MohamedMehery/Cosmalla_controller/HW/usb_relay_control/SRD-05VDC-SL-C/AR0458-Relevador-5V-DC-SRD-5VDC-SL-C-Pinout.jpg

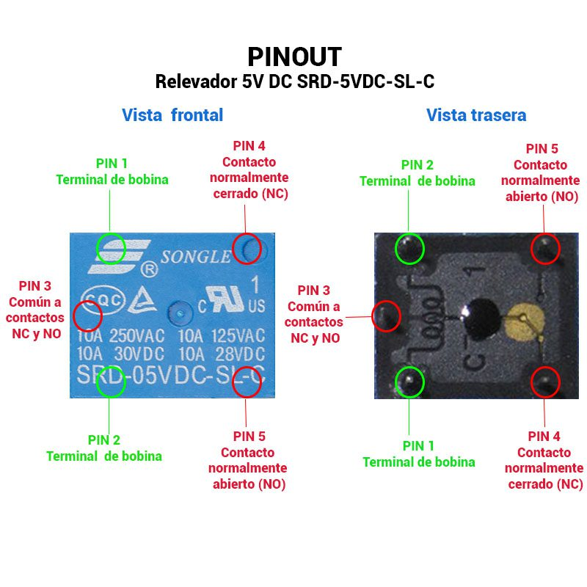
HW/usb_relay_control/SRD-05VDC-SL-C/AR0458-Relevador-5V-DC-SRD-5VDC-SL-C-Pinout.jpg
