MohamedMehery/Cosmalla_controller/HW/usb_relay_control/3D view/back view.PNG

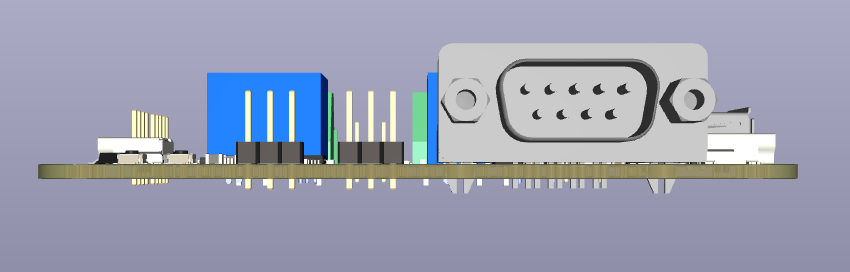
HW/usb_relay_control/3D view/back view.PNG
