MohamedMehery/Cosmalla_controller/HW/usb_relay_control/3D view/diag view.PNG

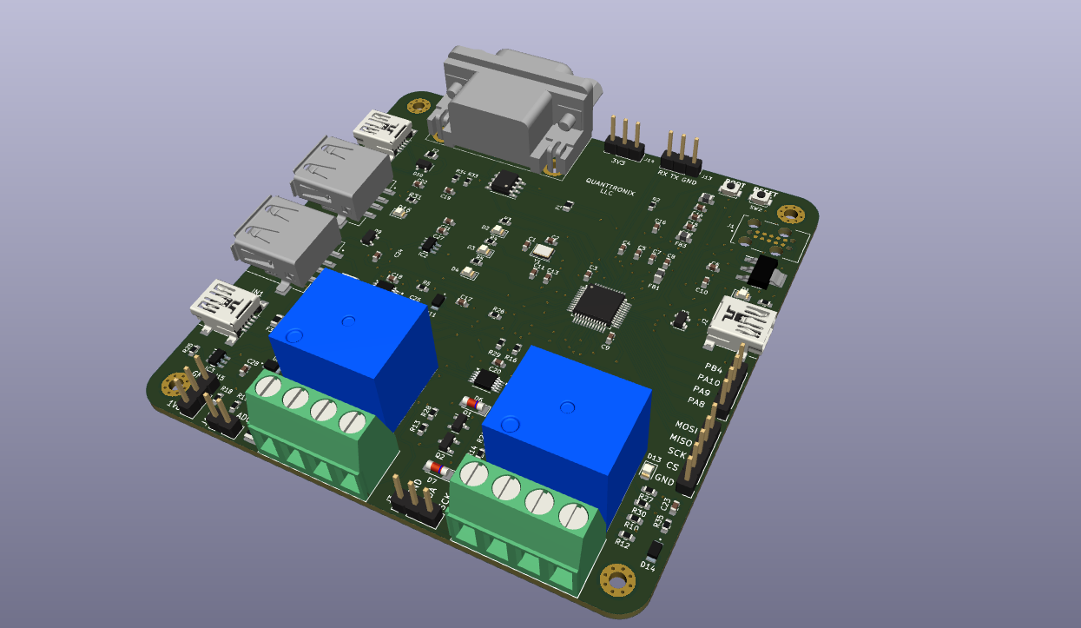
HW/usb_relay_control/3D view/diag view.PNG
