MohamedMehery/Cosmalla_controller/HW/usb_relay_control/3D view/top view.PNG

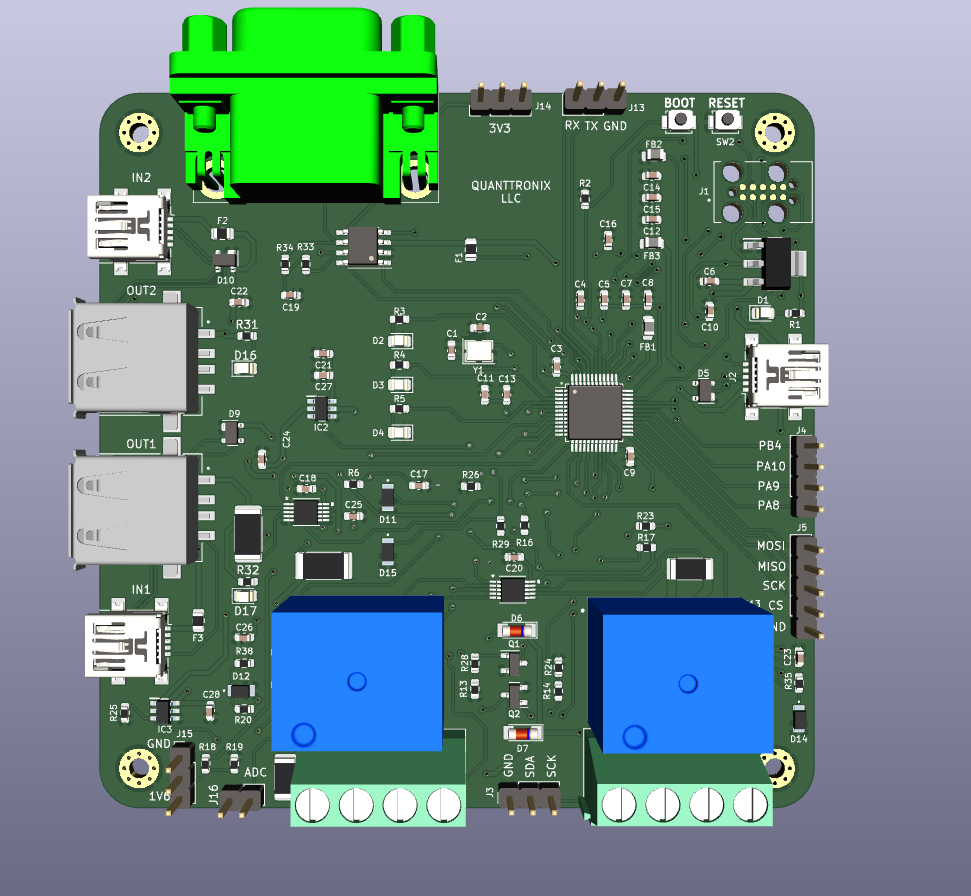
HW/usb_relay_control/3D view/top view.PNG
