MohamedMehery/Cosmalla_controller/HW/usb_relay_control/8.06.04_J-LINK_NEEDLE_ADAPTER/000000000022_IQVURnG.jpg

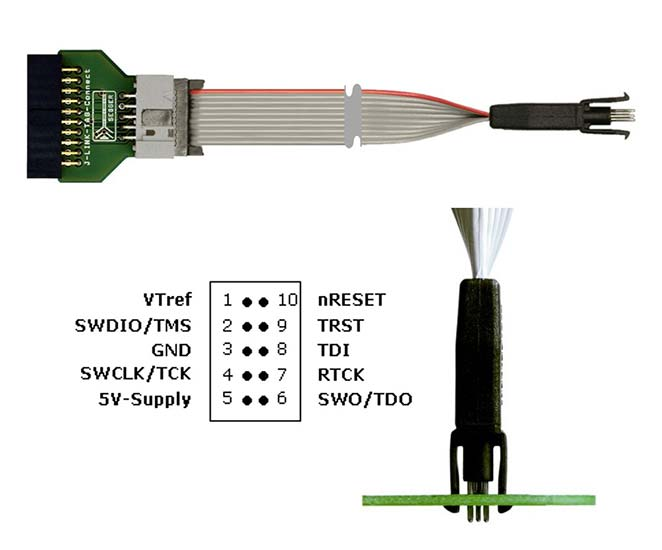
HW/usb_relay_control/8.06.04_J-LINK_NEEDLE_ADAPTER/000000000022_IQVURnG.jpg
