MohamedMehery/Cosmalla_controller/HW/usb_relay_control/relay circuit.PNG

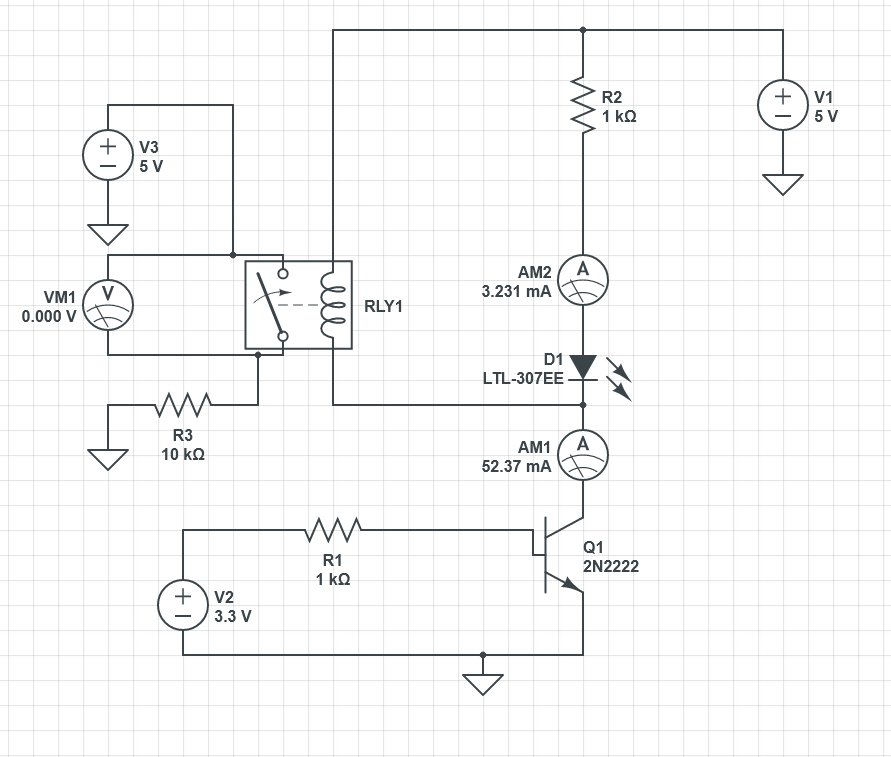
HW/usb_relay_control/relay circuit.PNG
