MohamedMehery/Cosmalla_controller/HW/usb_relay_control/BOM/Sample_BOM_PCB_DIGIKey.xlsx

PCB ASSEMBLY |  |  | xxxx xxxx xxxxx xxPCS BOM (Sample Bill of Materials)
Item # | *Designator | *Qty | Manufacturer | *Mfg Part # | Description / Value | *Package/Footprint | Type | Digikey Part # | Your Instructions / Notes
2 | J3J13J14J15J17J18J4J16J20J21J5J19 | 1 |  | 5-826629-0 | CONN HEADER VERT 50POS 2.54MM | CONN HEADER VERT 50POS 2.54MM | Through Hole | A121487-ND
6 | J6J7 | 2 | Phoenix Contact | 1729034 | 4 Position Wire to Board Terminal Block Horizontal with Board 0.197" (5.00mm) Through Hole | Horizontal with Board 0.197" (5.00mm) Through Hole | Through Hole | 277-1238-ND
7 | J11J12 | 2 | Amphenol ICC (FCI) | 87583-3010RPALF | USB-A (USB TYPE-A) USB 2.0 Receptacle Connector 4 Position Surface Mount, Right Angle | USB-A (USB TYPE-A) | SMD | 609-4946-1-ND
8 | R5 | 1 | KOA Speer Electronics, Inc. | RN73R2ATTD1670B25 | RES 167 OHM 0.1% 1/8W 0805 | 0805 | smd | 2019-RN73R2ATTD1670B25CT-ND
9 | R21R22 | 2 | Vishay Dale | WSL2512R0320FEA18 | RES 0.032 OHM 1% 2W 2512 | 2512 | smd | WSLH-.032CT-ND
10 | U4 | 1 | Texas Instruments | INA2181A1IDGSR | IC CURR SENSE 2 CIRCUIT 10VSSOP | 10-VSSOP | smd | 296-INA2181A1IDGSRCT-ND
11 | Y1 | 1 | ECS Inc. | ECS-160-9-33B-CTP-TR | CRYSTAL 16MHZ 9PF SMD |  | smd | 50-ECS-160-9-33B-CTP-CT-ND
12 | J22J23 | 2 | On Shore Technology Inc. | OSTVN02A150 | 2 Position Wire to Board Terminal Block Horizontal with Board 0.100" (2.54mm) Through Hole | 0.100" (2.54mm)Horizontal with Board | SMD | ED10561-ND
13 | IC2IC3 | 2 | Vishay Siliconix | SIP32509DT-T1-GE3 | Power Switch/Driver 1:1 N-Channel 3A TSOT-23-6 | TSOT-23-6 | SMD | SIP32509DT-T1-GE3CT-ND
14 | J10 | 1 | TE Connectivity AMP Connectors | 2311765-1 | 9 Position D-Sub Receptacle, Female Sockets Connector | Plug, FEMale Pins | SMD | 2311765-1-ND
15 | J2J8J9 | 3 | Würth Elektronik | 65100516121 | USB - mini B USB 2.0 Receptacle Connector 5 Position Surface Mount, Right Angle |  | SMD | 732-2109-1-ND
