MohamedMehery/Cosmalla_controller/HW/usb_relay_control/BOM/Sample_BOM_PCB_LCSC.xlsx

*Designator | *Qty | *Mfg Part # | *Package/Footprint | Type | LCSC Part # | Manufacturer | Description / Value | Your Instructions / Notes
C12C13C23C26C31C32C33 | 7 | VJ0805Y103KXACW1BC | 0805 (2012 Metric) | SMD | C2169545 | Vishay Intertech | 50V 10nF X7R ±10% 0805 Multilayer Ceramic Capacitors MLCC
C19 | 1 | CL21C472JBC1PNC | 0805 (2012 Metric) | SMD | C472844 | Samsung Electro-Mechanics | 50V 4.7nF C0G ±5% 0805 Multilayer Ceramic Capacitors MLCC - SMD/SMT ROHS
C1C2 | 2 | CC0805DRNPO9BN8R0 | 0805 (2012 Metric) | SMD | C519959 | YAGEO | 50V 8pF NP0 0805 Multilayer Ceramic Capacitors MLCC - SMD/SMT ROHS
C3C14C21C22C10 | 5 | GRT21BC8YA475KE13L | 0805 (2012 Metric) | SMD | C711102 | Murata Electronics | 35V 4.7uF X6S ±10% 0805 Multilayer Ceramic Capacitors MLCC - SMD/SMT ROHS
C15C16C17C18C20C24C25C27C28C29C30C35 | 12 | VJ0805Y104KXATW1BC | 0805 (2012 Metric) | SMD | C2169721 | Vishay Intertech | 50V 100nF X7R ±10% 0805 Multilayer Ceramic Capacitors MLCC - SMD/SMT ROHS
C6C11 | 2 | AC0805KKX7R6BB105 | 0805 (2012 Metric) | SMD | C726581 | YAGEO | 10V 1uF X7R ±10% 0805 Multilayer Ceramic Capacitors MLCC - SMD/SMT ROHS
C34 | 1 | GRM21BR60G476ME01L | 0805 (2012 Metric) | SMD | C5274022 | Murata Electronics | 4V 47uF ±20% 0805 Multilayer Ceramic Capacitors MLCC - SMD/SMT ROHS
C4C5C7C8C9 | 5 | GRT21BC71E106KE13L | 0805 (2012 Metric) | SMD | C882505 | Murata Electronics | 25V 10uF ±10% 0805 Multilayer Ceramic Capacitors MLCC - SMD/SMT ROHS
D1D2D16D17D8D13 | 6 | MHT170CRCT | 0805 (2012 Metric) | SMD | C389523 | MEIHUA | 617.5nm~633.5nm Red 0805 Light Emitting Diodes (LED) ROHS
D3 | 1 | LTST-C171GKT | 0805 (2012 Metric) | SMD | C913075 | LTST-C171GKT | GREENLED
D4 | 1 | NCD0805G1 | 0805 (2012 Metric) | SMD | C84260 | Lite-On Inc. | BLUELED
D5D9D10D18D19 | 5 | PRTR5V0U2X,215 | SOT-143B | SMD | C12333 | Nexperia USA Inc. | TVS DIODE 5.5VWM SOT143B
D6D7 | 2 | TZMC75-GS08 | SOD-80 | smd | C3013862 | Vishay Intertech | Diode 100 V 150mA Surface Mount Mini MELF
DNP_R39DNP_R40 | 2 | RC0805FR-0710KL | 0805 | smd | C84376 | YAGEO | 10 kOhms ±5% 0.25W, Chip Resistor 0603 (1608 Metric)
F1F2F3 | 3 | 0805L100WR | 0805 (2012 Metric), Concave | SMD | C80270 | Littelfuse Inc. | Polymeric PTC Resettable Fuse 6V 1 A Ih Surface Mount 0805 (2012 Metric), Concave
FB1FB2FB3 | 3 | MPZ2012S101ATD25 | 0805 | smd | C307776 | TDK | 20mΩ 100Ω@100MHz 0805 Ferrite Beads ROHS
IC1 | 1 | LDL1117S33R | SOT-223 | SMD | C435835 | STMicroelectronics | Linear Voltage Regulator IC Positive Fixed 1 Output 1.2A SOT-223
R11R12 | 2 | RT0805CRD0747KL | 0805 | smd | C868380 | YAGEO | 125mW Thin Film Resistor ±0.25% 47kΩ 0805 Chip Resistor - Surface Mount ROHS
R14R15R27R28RR31R32 | 6 | AR05CTC1000 | 0805 | smd | C2902822 | Viking Tech | 100mW Thin Film Resistor ±0.25% 1kΩ 0805 Chip Resistor - Surface Mount ROHS
R16R20R30 | 3 | AR05DTCW0100 | 0805 | smd | C319925 | Viking Tech (https://www.lcsc.com/brand-detail/346.html) | 125mW Thin Film Resistor ±0.5% 10Ω 0805 Chip Resistor - Surface Mount ROHS
R17R23 | 2 | RT0805BRD071K78L | 0805 | smd | C706226 | YAGEO | 125mW Thin Film Resistor ±0.1% 1.78kΩ 0805 Chip Resistor - Surface Mount ROHS
R1R3 | 2 | PTFR0805B332RP9 | 0805 | smd | C2849181 | Resistor.Today | 0.13W Thin Film Resistor ±0.1% 332Ω 0805 Chip Resistor - Surface Mount ROHS
R29R35R36R37R38 | 5 | AR05BTCW1500 | 0805 | smd | C319863 | Viking Tech | 125mW Thin Film Resistor ±0.1% 150Ω 0805 Chip Resistor
R2R6R13R18R19R24R25R26 | 8 | RC0805FR-0710KL | 0805 | smd | C84376 | YAGEO | 200mW Thin Film Resistor ±0.1% 10kΩ 0805 Chip Resistor
R33R34 | 2 | CRCW080560R4FKEAHP | 0805 | smd | C1880864 | Vishay Intertech | 500mW Thick Film Resistors ±1% 60.4Ω 0805 Chip Resistor
R4 | 1 | HPCR0805F300RK9 | 0805 | smd | C365284 | Resistor.Today | 250mW Thick Film Resistors ±1% 300Ω 0805 Chip Resistor
R41R42 R43 | 3 | PA0805-R-470RL | 0805 | SMD | C858567 | YAGEO | 1/5W 0Ω 0805 Chip Resistor - Surface Mount ROHS
R7R9 | 2 | RLM20FECR020 | 2010 | smd | C912937 | TA-I Tech | RES 0.02 OHM 1% 2010
R8R10 | 2 | RT0805BRD07124KL | 0805 | smd | C865165 | YAGEO | 125mW Thin Film Resistor ±0.1% 124kΩ 0805 Chip Resistor
R44R45 | 2 | PTFR0805B100KP9 | 0806 | smd | C478884 | Resistor.Today | 100K
R46 | 1 | PTFR0805B1K50N9 | 0805 | SMD | C351598 | Resistor.Today | 1.5K
SW1SW2 | 2 | B3U-1000P | 0805 | smd | C231329 | Omron Electronics Inc-EMC Div | SWITCH TACTILE SPST-NO 0.05A 12V
U1 | 1 | STM32F103CBT6 | 48-LQFP | smd | C8304 | STMicroelectronics | ARM® Cortex®-M3 STM32F1 Microcontroller IC 32-Bit Single-Core 72MHz 128KB (128K x 8) FLASH
U3 | 1 | TJA1051T/3,118 | SOIC-8 | SMD | C58988 | NXP Semiconductors (https://www.mouser.com/manufacturer/nxp-semiconductors/) | CAN Interface IC Hi Spd CAN Transcvr 4.5V-5.5V 250ns
