MohamedMehery/Cosmalla_controller/HW/usb_relay_control/BOM/Sample_BOM_PCB_Mouser.xlsx

Sheet: Sheet1
Item # | *Designator | *Qty | Manufacturer | *Mfg Part # | Description / Value | *Package/Footprint | Type | Mouser Part # | Your Instructions / Notes
1 | U2 | 1 | Texas Instruments (https://www.mouser.com/manufacturer/texas-instruments/) | INA2181A3QDGSRQ1 | Current Sense Amplifiers AEC-Q100, 26V, dual channel, bi-directional, 350kHz current sense amplifier 10-VSSOP -40 to 125 | MSOP-10 | SMD | 595-INA2181A3QDGSRQ1
2 | U3 | 1 | NXP Semiconductors (https://www.mouser.com/manufacturer/nxp-semiconductors/) | TJA1051T/3,118 | CAN Interface IC Hi Spd CAN Transcvr 4.5V-5.5V 250ns | SOIC-8 | SMD | 771-TJA1051T3118 |  | On LCSC
2 | D11D12D14 | 3 | Taiwan Semiconductor (https://www.mouser.com/manufacturer/taiwan-semiconductor/) | BZY55C3V3 RYG | Zener Diodes 500mW, 2%, Small Signal Zener Diode | 0805 | SMD | 821-BZY55C3V3RYG
3 | Q1Q2 | 2 | Diotec Semiconductor (https://www.mouser.com/manufacturer/diotec-semiconductor/) | MMBT3904 | Bipolar Transistors - BJT BJT, SOT-23, 40V, 200mA, NPN | SOT-23 | SMD | 637-MMBT3904
4 | F6 | 1 | Bourns (https://www.mouser.com/manufacturer/bourns/) | SF-0603S070-2 | Surface Mount Fuses 0.7A Slow Blow 0603 Singlfuse | 0603 | SMD | 652-SF-0603S070-2
5 | F4F5 | 2 | KYOCERA AVX (https://www.mouser.com/manufacturer/kyocera-avx/) | F0603G0R02FNTR | Surface Mount Fuses 0603 28mA 63V 0603 | 0603 | SMD | 581-F0603G0R02FNTR

Sheet: Sheet2
Item # | *Designator | *Qty | Manufacturer | *Mfg Part # | Description / Value | *Package/Footprint | Type | Mouser Part # | Your Instructions / Notes
1 | U2 | 1 | Texas Instruments (https://www.mouser.com/manufacturer/texas-instruments/) | INA2181A3QDGSRQ1 | Current Sense Amplifiers AEC-Q100, 26V, dual channel, bi-directional, 350kHz current sense amplifier 10-VSSOP -40 to 125 | MSOP-10 | SMD | 595-INA2181A3QDGSRQ1
2 | U3 | 1 | NXP Semiconductors (https://www.mouser.com/manufacturer/nxp-semiconductors/) | TJA1051T/3,118 | CAN Interface IC Hi Spd CAN Transcvr 4.5V-5.5V 250ns | SOIC-8 | SMD | 771-TJA1051T3118 |  | On LCSC
3 | D11D12D14D15 | 4 | Taiwan Semiconductor (https://www.mouser.com/manufacturer/taiwan-semiconductor/) | BZY55B3V3 RBG | Zener Diodes 500mW, 2%, Small Signal Zener Diode | 0805 | SMD | 821-BZY55B3V3RBG
4 | Q1Q2 | 2 | Diotec Semiconductor (https://www.mouser.com/manufacturer/diotec-semiconductor/) | MMBT3904 | Bipolar Transistors - BJT BJT, SOT-23, 40V, 200mA, NPN | SOT-23 | SMD | 637-MMBT3904
