MohamedMehery/Cosmalla_controller/HW/usb_relay_control/8.06.04_J-LINK_NEEDLE_ADAPTER/8.06.04_J-LINK_NEEDLE_ADAPTER.step

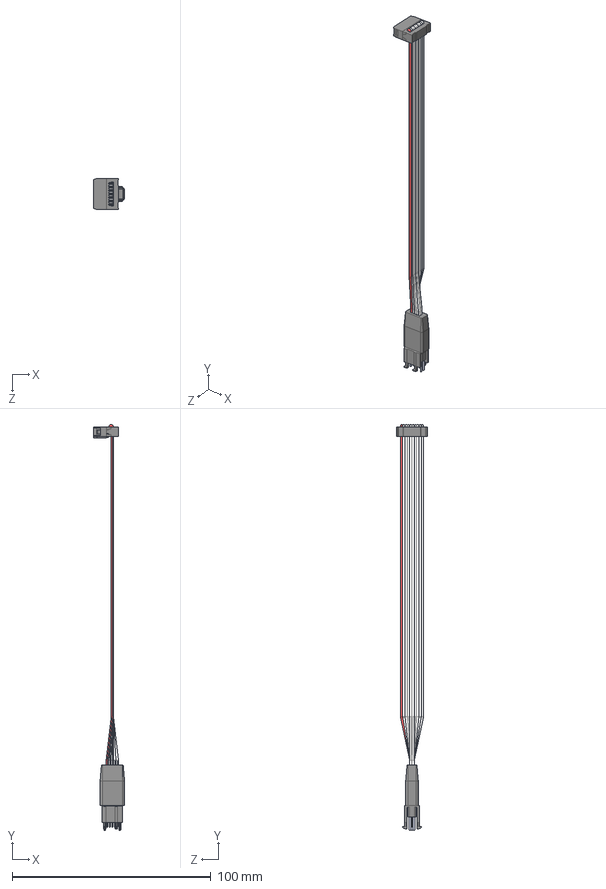
[picture p11: CAD file, 2026-05-07]
HW/usb_relay_control/8.06.04_J-LINK_NEEDLE_ADAPTER/8.06.04_J-LINK_NEEDLE_ADAPTER.step
15.7 x 204.4 x 15.7 mm
8.06.04 J-LINK NEEDLE ADAPTER
cable and adapter
