MohamedMehery/Cosmalla_controller/HW/usb_relay_control/INA4181A1IPWR/INA4181A1IPWR.step

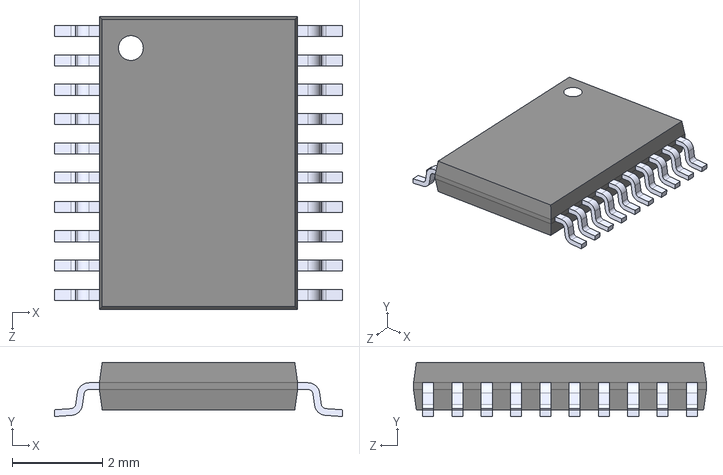
[picture p12: CAD file, 2026-05-07]
HW/usb_relay_control/INA4181A1IPWR/INA4181A1IPWR.step
6.40 x 1.20 x 6.50 mm
