MohamedMehery/Cosmalla_controller/HW/usb_relay_control/LDL1117S33R/LDL1117S33R.step

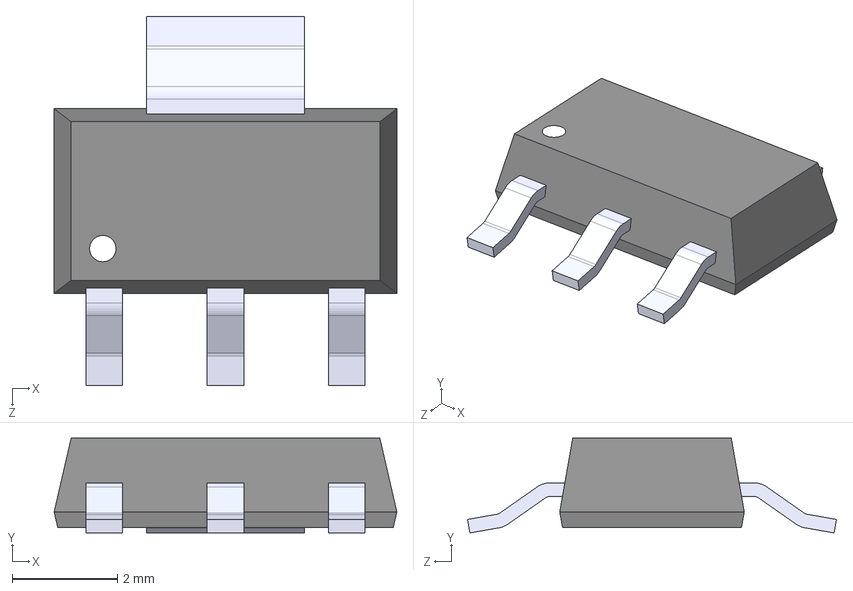
[picture p13: CAD file, 2026-05-08]
HW/usb_relay_control/LDL1117S33R/LDL1117S33R.step
6.50 x 1.80 x 7.00 mm
