MohamedMehery/Cosmalla_controller/HW/usb_relay_control/LIB_BZY55B3V3_RBG/BZY55B3V3_RBG/3D/BZY55B3V3_RBG.stp

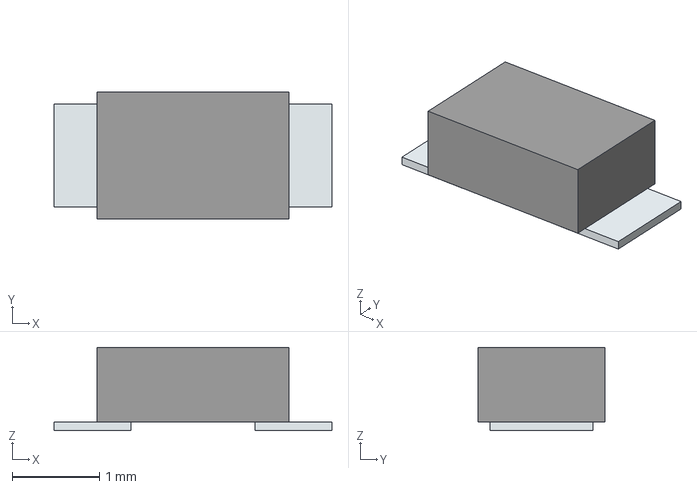
[picture p14: CAD file, 2026-05-08]
HW/usb_relay_control/LIB_BZY55B3V3_RBG/BZY55B3V3_RBG/3D/BZY55B3V3_RBG.stp
3.18 x 1.45 x 0.95 mm
Pins
