MohamedMehery/Cosmalla_controller/HW/usb_relay_control/LIB_IRF7470TRPBF/IRF7470TRPBF/3D/IRF7470TRPBF.stp

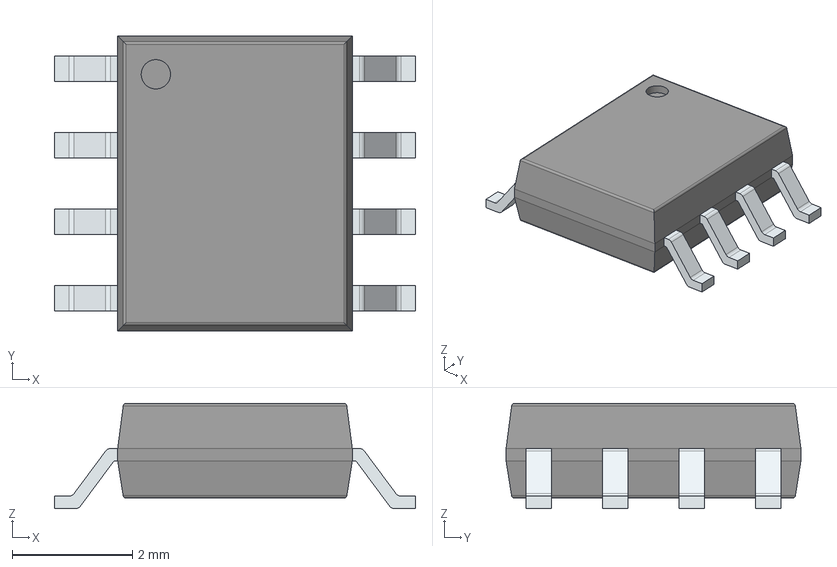
[picture p15: CAD file, 2026-05-08]
HW/usb_relay_control/LIB_IRF7470TRPBF/IRF7470TRPBF/3D/IRF7470TRPBF.stp
6.00 x 4.90 x 1.75 mm
PinsArrayLR
