MohamedMehery/Cosmalla_controller/HW/usb_relay_control/LIB_LDL1117S50R/LDL1117S50R/3D/LDL1117S50R.stp

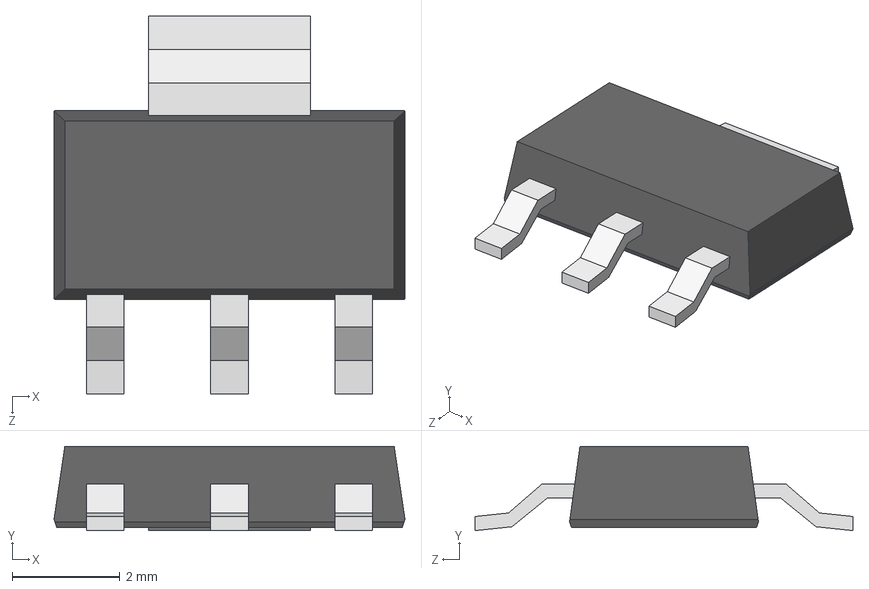
[picture p16: CAD file, 2026-05-07]
HW/usb_relay_control/LIB_LDL1117S50R/LDL1117S50R/3D/LDL1117S50R.stp
6.50 x 1.56 x 7.00 mm
