MohamedMehery/Cosmalla_controller/HW/usb_relay_control/LIB_LMR1802G-LBTR/LMR1802G-LBTR/3D/LMR1802G-LBTR.stp

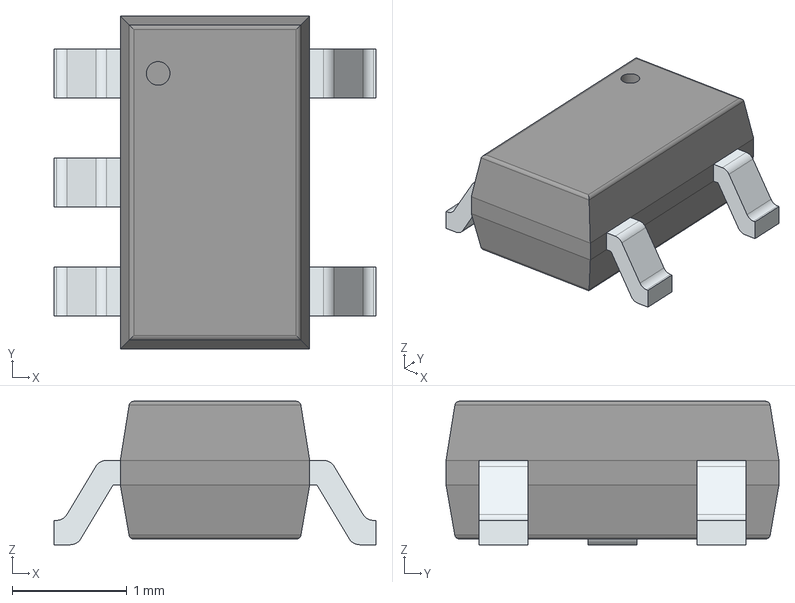
[picture p17: CAD file, 2026-05-07]
HW/usb_relay_control/LIB_LMR1802G-LBTR/LMR1802G-LBTR/3D/LMR1802G-LBTR.stp
2.80 x 2.90 x 1.25 mm
PinsArrayL
PinsArrayR
