MohamedMehery/Cosmalla_controller/HW/usb_relay_control/LIB_MAX7301AAX/MAX7301AAX+/3D/MAX7301AAX+.stp

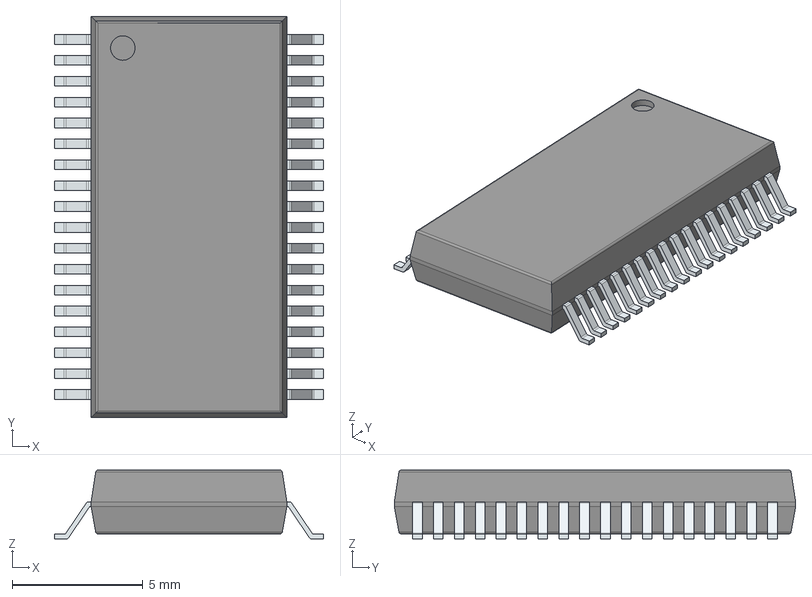
[picture p18: CAD file, 2026-05-07]
HW/usb_relay_control/LIB_MAX7301AAX/MAX7301AAX+/3D/MAX7301AAX+.stp
10.3 x 15.4 x 2.64 mm
PinsArrayLR
