MohamedMehery/Cosmalla_controller/HW/usb_relay_control/LIB_MMBT2222LT1G/MMBT2222LT1G/MMBT2222LT1G.stp

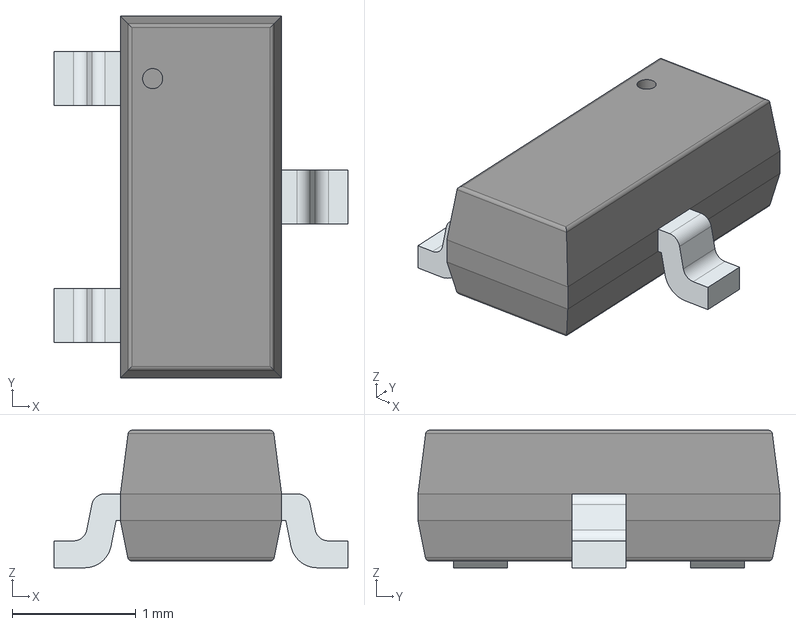
[picture p19: CAD file, 2026-05-08]
HW/usb_relay_control/LIB_MMBT2222LT1G/MMBT2222LT1G/MMBT2222LT1G.stp
2.37 x 2.92 x 1.11 mm
PinsArrayL
FilletPinR
