MohamedMehery/Cosmalla_controller/HW/usb_relay_control/LIB_TCAN1042HDRQ1/TCAN1042HDRQ1/3D/TCAN1042HDRQ1.stp

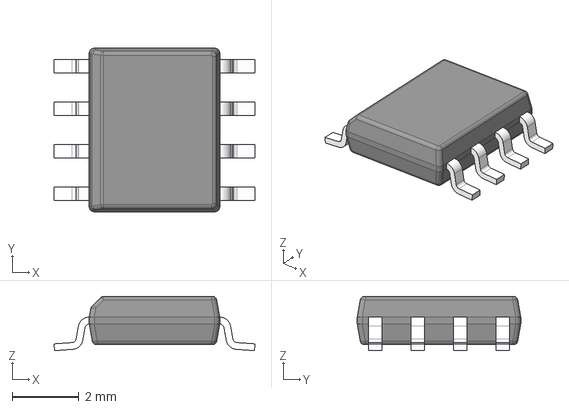
[picture p20: CAD file, 2026-05-07]
HW/usb_relay_control/LIB_TCAN1042HDRQ1/TCAN1042HDRQ1/3D/TCAN1042HDRQ1.stp
6.02 x 4.90 x 1.63 mm
BODY-SO
LEAD-D0008A x 8
