MohamedMehery/Cosmalla_controller/HW/usb_relay_control/SRD-05VDC-SL-C/SRD-05VDC-SL-C.step

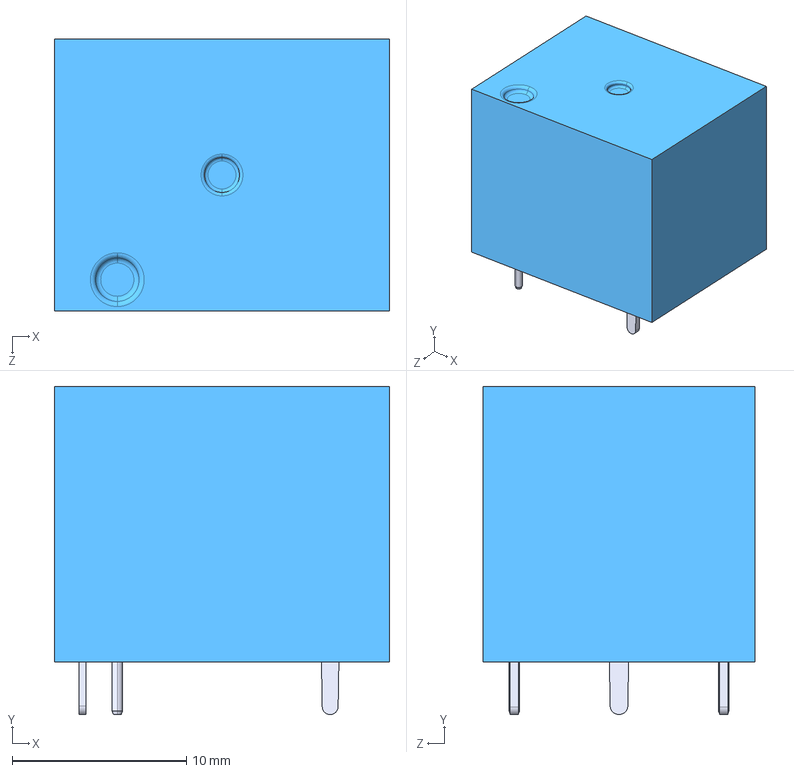
[picture p21: CAD file, 2026-05-07]
HW/usb_relay_control/SRD-05VDC-SL-C/SRD-05VDC-SL-C.step
19.2 x 18.8 x 15.6 mm
