MohamedMehery/Cosmalla_controller/HW/usb_relay_control/ul_INA2181A1IDGSR/ul_INA2181A1IDGSR/2023-02-03_08-18-01/DGS0010A.stp

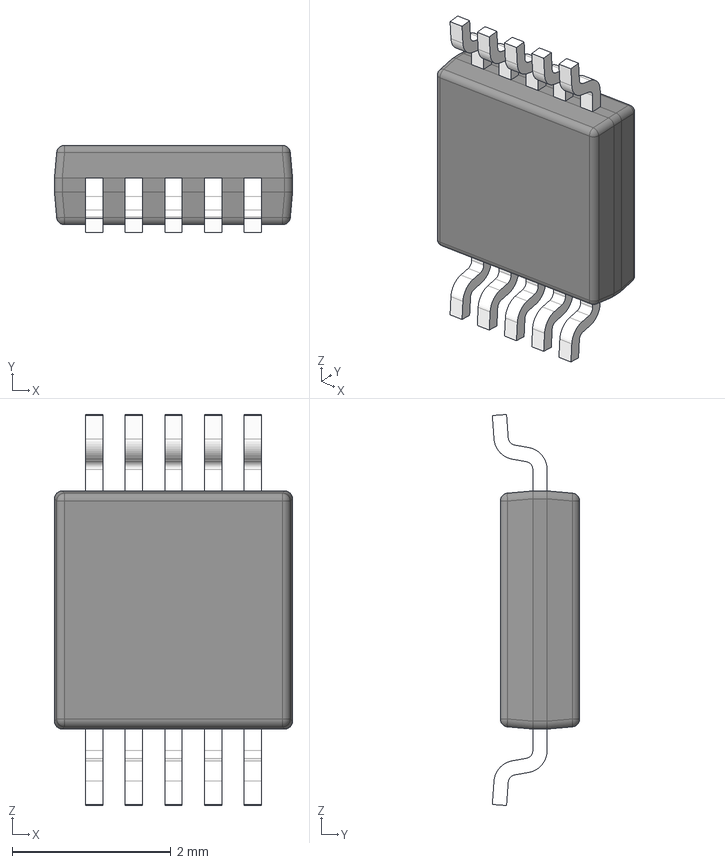
[picture p22: CAD file, 2026-05-08]
HW/usb_relay_control/ul_INA2181A1IDGSR/ul_INA2181A1IDGSR/2023-02-03_08-18-01/DGS0010A.stp
3.00 x 1.10 x 4.93 mm
BODY-SO
LEAD-SO x 10
PIN1-ID
