MohamedMehery/Cosmalla_controller/HW/usb_relay_control/136415089-659-2301843-1/2301843-1.stp

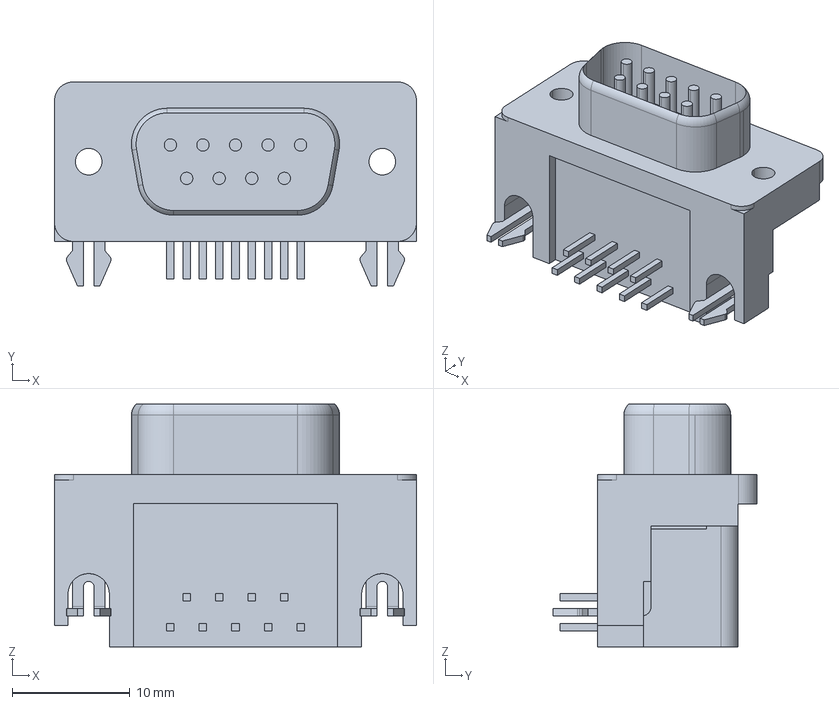
[picture p23: CAD file, 2026-05-08]
HW/usb_relay_control/136415089-659-2301843-1/2301843-1.stp
30.8 x 17.4 x 20.6 mm
