MohamedMehery/Cosmalla_controller/HW/usb_relay_control/LIB_2301843-2/2301843-2/3D/2301843-2.stp

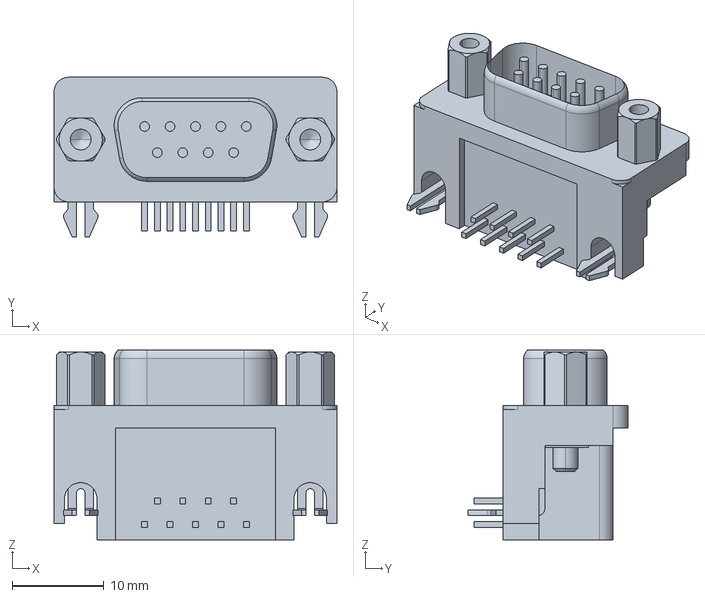
[picture p24: CAD file, 2026-05-07]
HW/usb_relay_control/LIB_2301843-2/2301843-2/3D/2301843-2.stp
30.8 x 17.4 x 20.6 mm
