MohamedMehery/Cosmalla_controller/HW/usb_relay_control/LIB_292303-9/292303-9/292303-9/292303-9.step

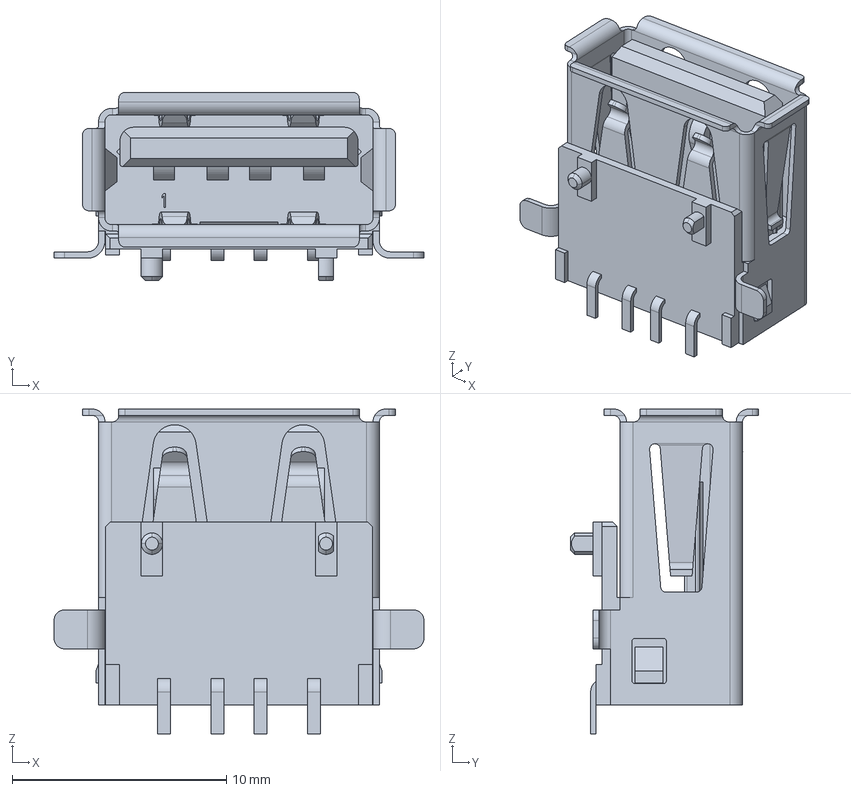
[picture p25: CAD file, 2026-05-08]
HW/usb_relay_control/LIB_292303-9/292303-9/292303-9/292303-9.step
17.3 x 8.79 x 15.2 mm
