MohamedMehery/Cosmalla_controller/HW/usb_relay_control/LIB_87583-3010RPALF/87583-3010RPALF--3DModel-STEP-269445.STEP

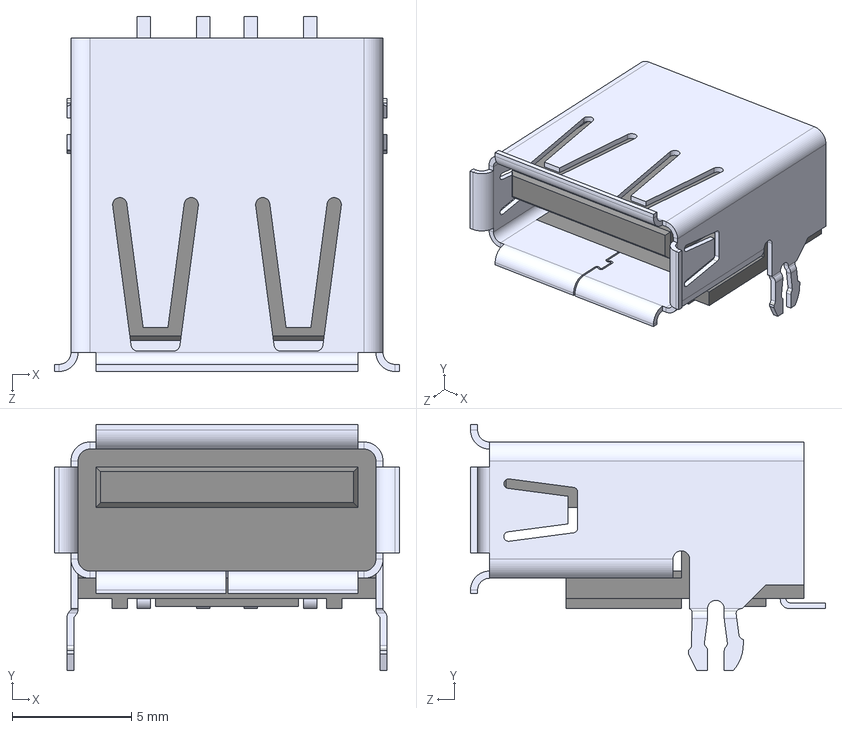
[picture p26: CAD file, 2026-05-08]
HW/usb_relay_control/LIB_87583-3010RPALF/87583-3010RPALF--3DModel-STEP-269445.STEP
14.5 x 10.3 x 14.9 mm
