MohamedMehery/Cosmalla_controller/(list of files, cad)

Other CAD files:
HW/usb_relay_control/LIB_292303-9/292303-9/3D/292303-9.stp
HW/usb_relay_control/LIB_87583-3010RPALF/87583-3010RPALF/3D/87583-3010RPALF.stp
HW/usb_relay_control/LIB_LDL1117S50R/LDL1117S50R/Allegro/sot230p700x180-4n.psm
HW/usb_relay_control/LIB_LDL1117S50R/LDL1117S50R/DEHDL/ldl1117s50r/chips/chips.prt
HW/usb_relay_control/LIB_LMR1802G-LBTR/LMR1802G-LBTR/Allegro/sot95p280x125-5n.psm
HW/usb_relay_control/LIB_LMR1802G-LBTR/LMR1802G-LBTR/DEHDL/lmr1802g_lbtr/chips/chips.prt
HW/usb_relay_control/LIB_SIP32509DT-T1-GE3/SIP32509DT-T1-GE3/3D/SIP32509DT-T1-GE3.stp
