MohamedMehery/Cosmalla_controller/HW/usb_relay_control/usb_relay_control.pdf

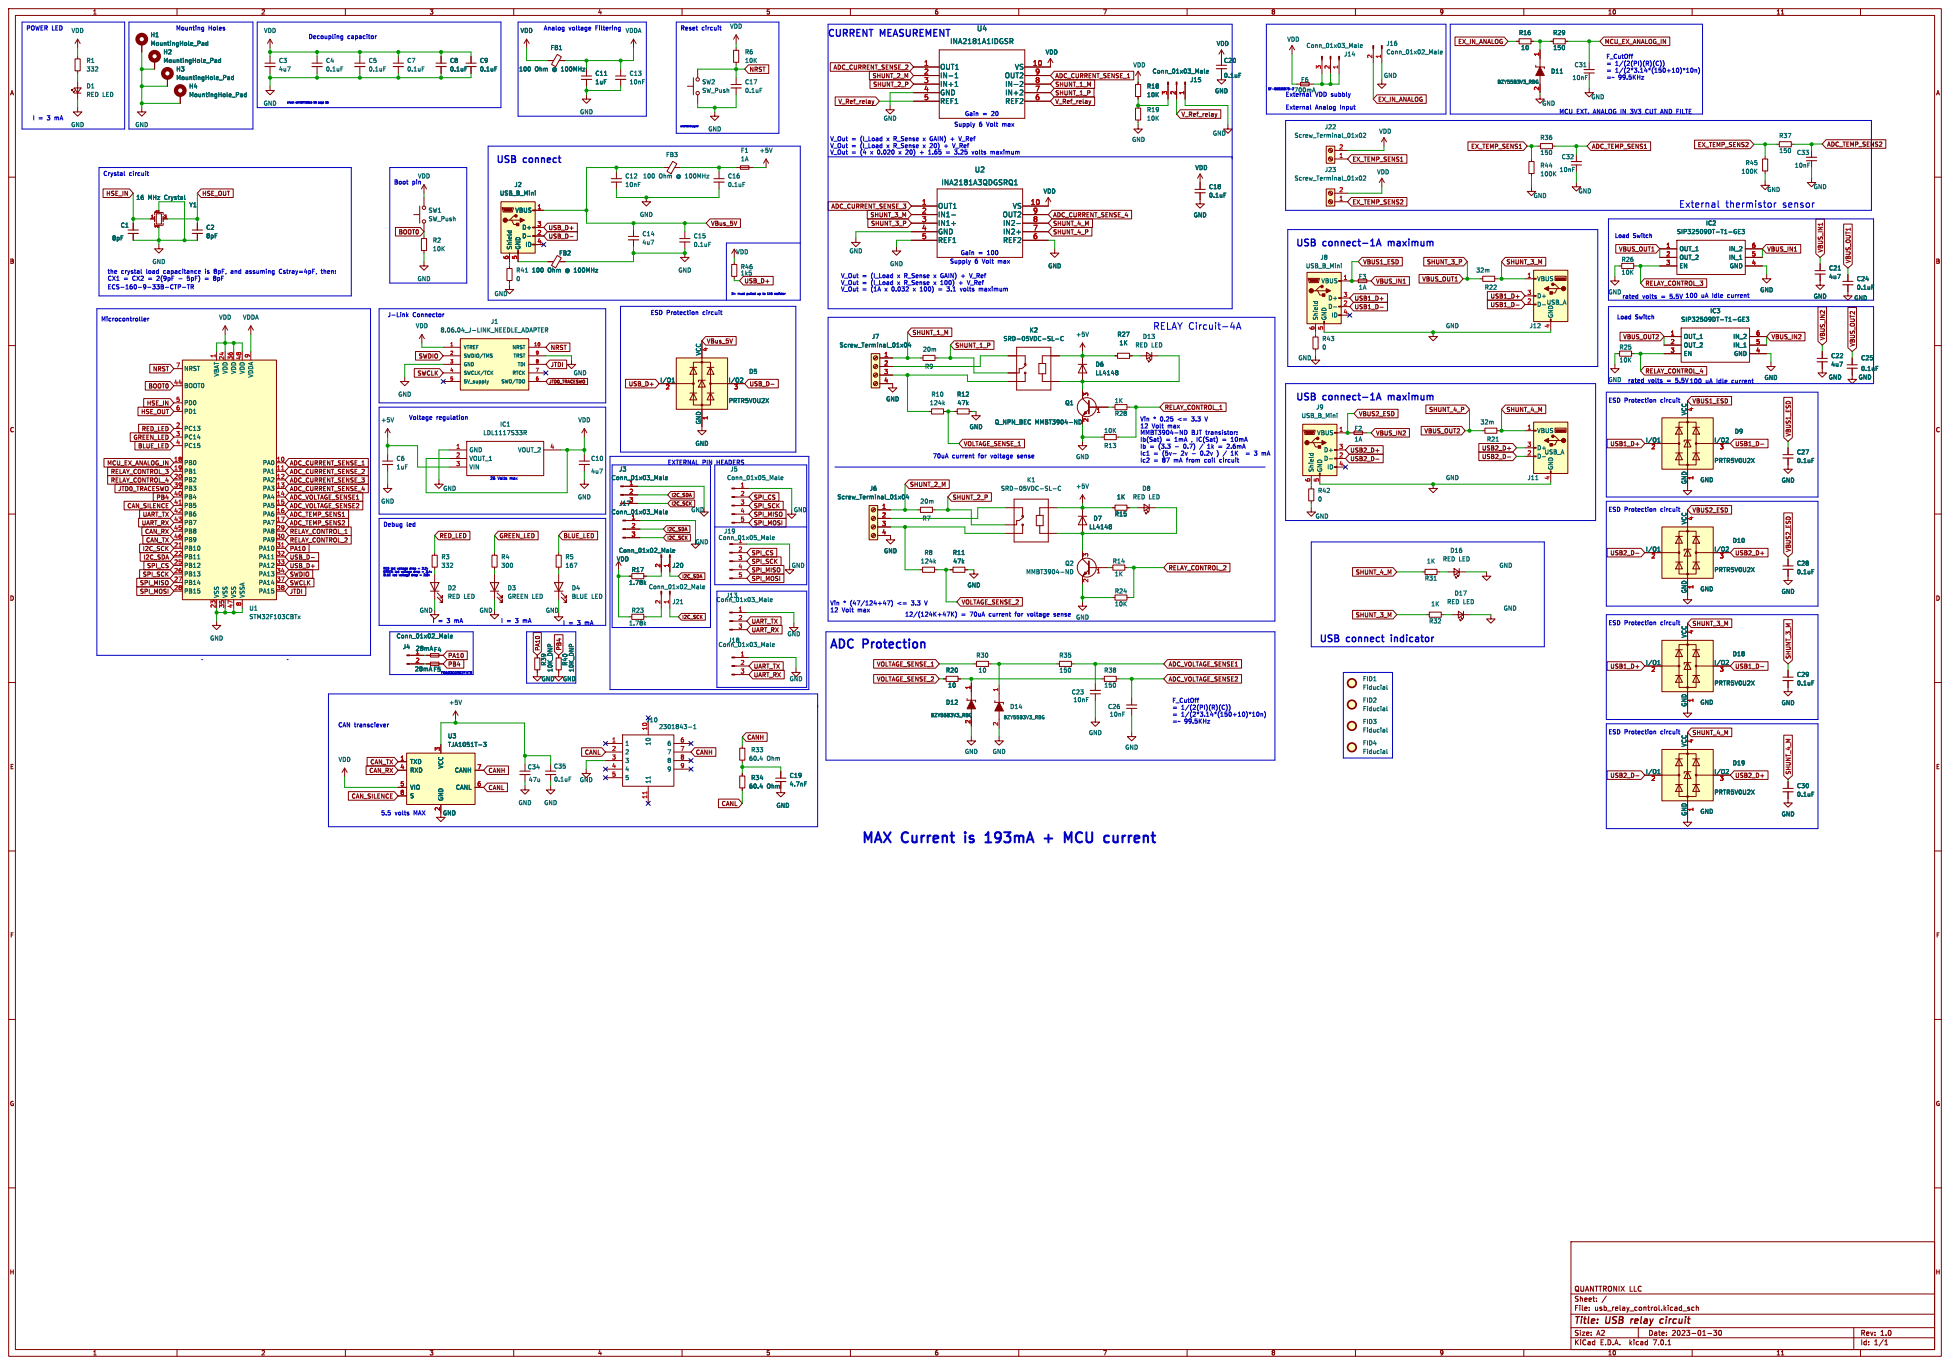
[picture p27: page 1]

rated volts = 5.5V CURRENT MEASUREMENT Analog voltage Filtering

J16 Conn_01x02_Male VDD
J14 Conn_01x03_Male F6
F_CutOff = 1/(2(PI)(R)(C)) = 1/(2*3.14*(150+10)*10n) =~ 99.5KHz MCU EXT. ANALOG IN 3V3 CUT AND FILTE USB connect indicator

External VDD subbly External Analog Input

Load Switch ESD Protection circuit

1 PA0 10 PA1 11 PA2 12 PA3 13 PA4 14 PA5 15 PA6 16 PA7 17 PB0 18 PB1 19 PC13 2 PB2 20 PB10 21 PB11 22 VSS 23 VDD 24 PB12 25 PB13 26 PB14 27 PB15 28 PA8 29 PC14 3 PA9 30 PA10 31 PA11 32 PA12 33 PA13 34 VSS 35 VDD 36 PA14 37 PA15 38 PB3 39 PC15 4 PB4 40 PB5 41 PB6 42 PB7 43 BOOT0 44 PB8 45 PB9 46 VSS 47 VDD 48 PD0 5 PD1 6 NRST 7 VSSA

Ib(Sat) = 1mA , IC(Sat) = 10mA

3 RXD 4 VIO 5 CANL 6 CANH 7 S
