MohamedMehery/Cosmalla_controller/(list of files, drawings)

Other design files:
HW/usb_relay_control/LIB_LDL1117S50R/LDL1117S50R/Altium/LDL1117S50R.SchLib
HW/usb_relay_control/LIB_LDL1117S50R/LDL1117S50R/Altium/SOT230P700X180-4N.PcbLib
HW/usb_relay_control/LIB_LMR1802G-LBTR/LMR1802G-LBTR/Altium/LMR1802G-LBTR.SchLib
HW/usb_relay_control/LIB_LMR1802G-LBTR/LMR1802G-LBTR/Altium/SOT95P280X125-5N.PcbLib
