MohamedMehery/Cosmalla_controller/HW/usb_relay_control/usb_relay_control.kicad_pcb

## KiCad design HW/usb_relay_control/usb_relay_control.kicad_pcb (2026-05-08)

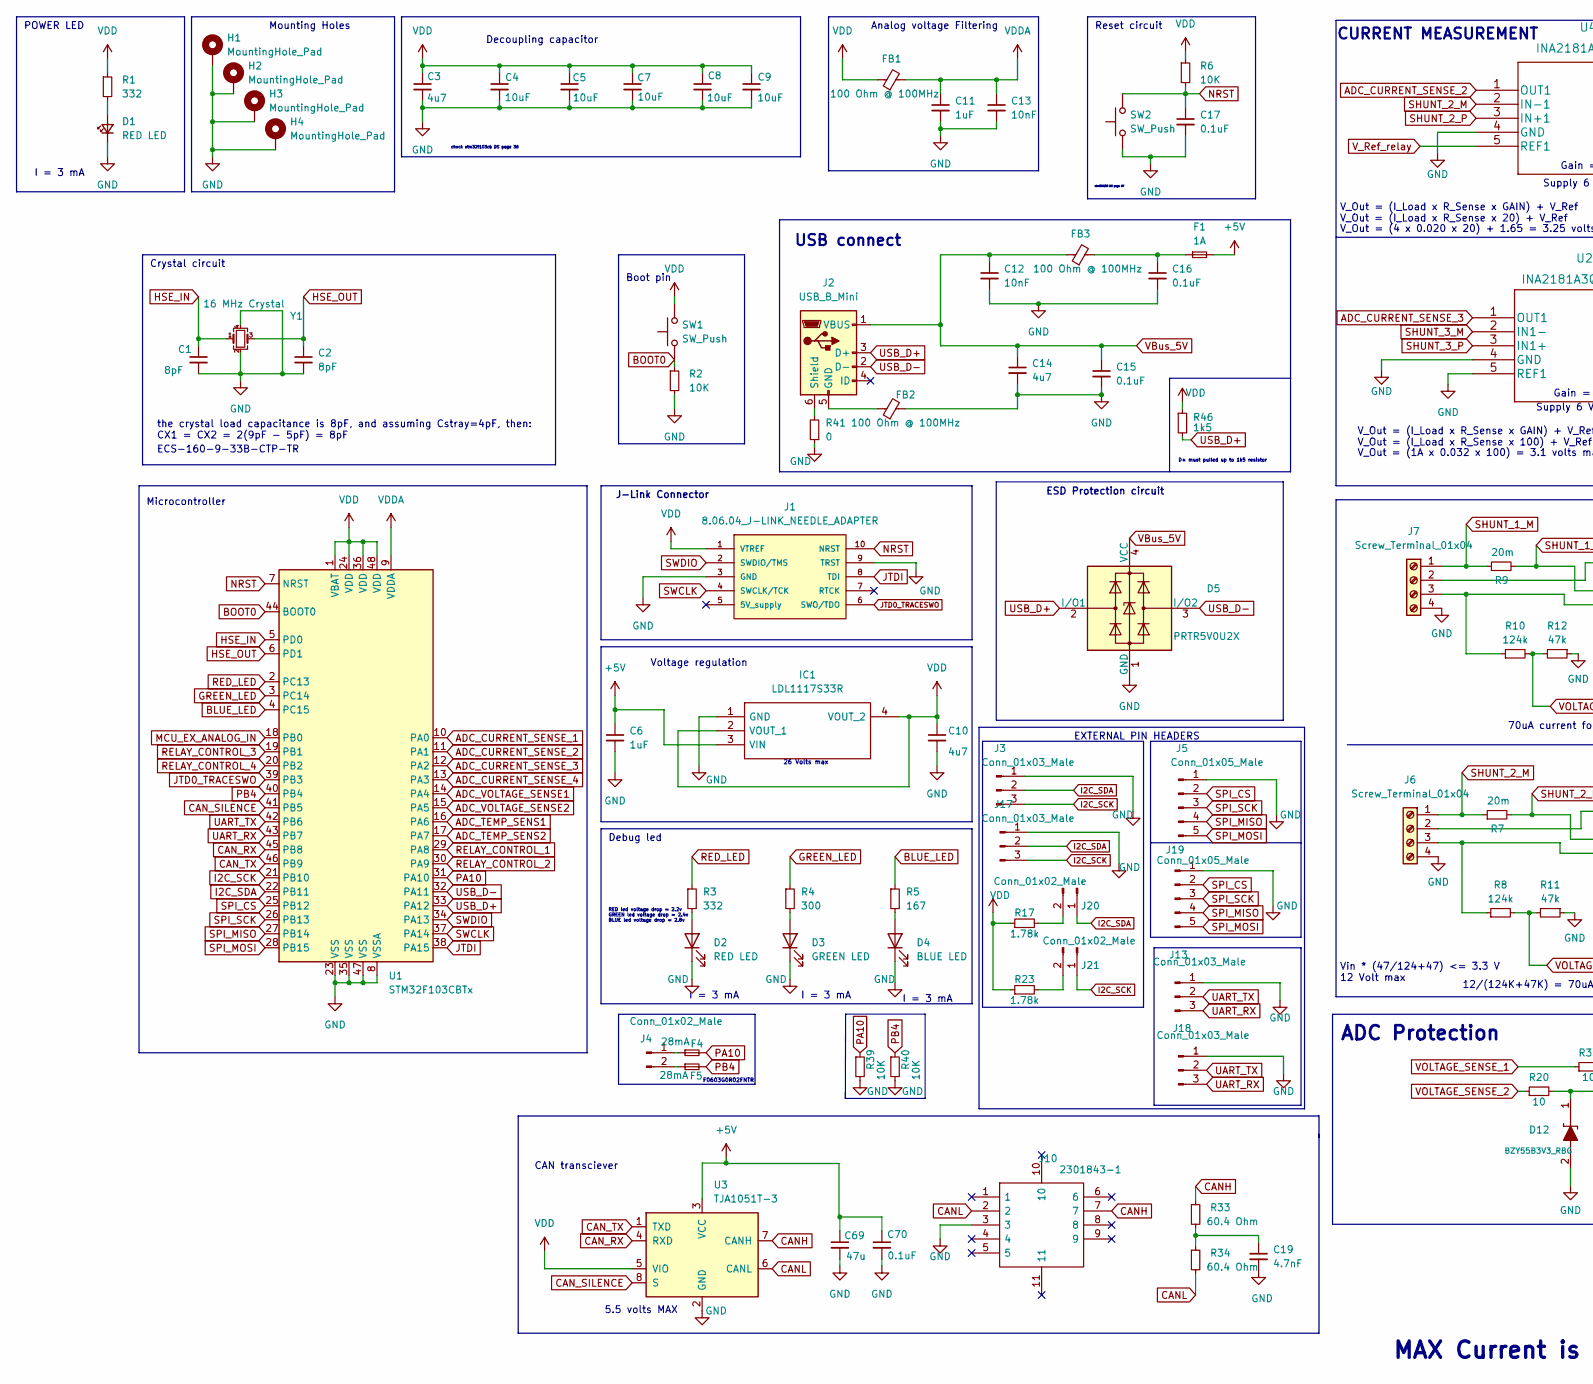
[picture p28: schematic usb_relay_control.kicad_sch, USB relay circuit, part in row 1, column 1]

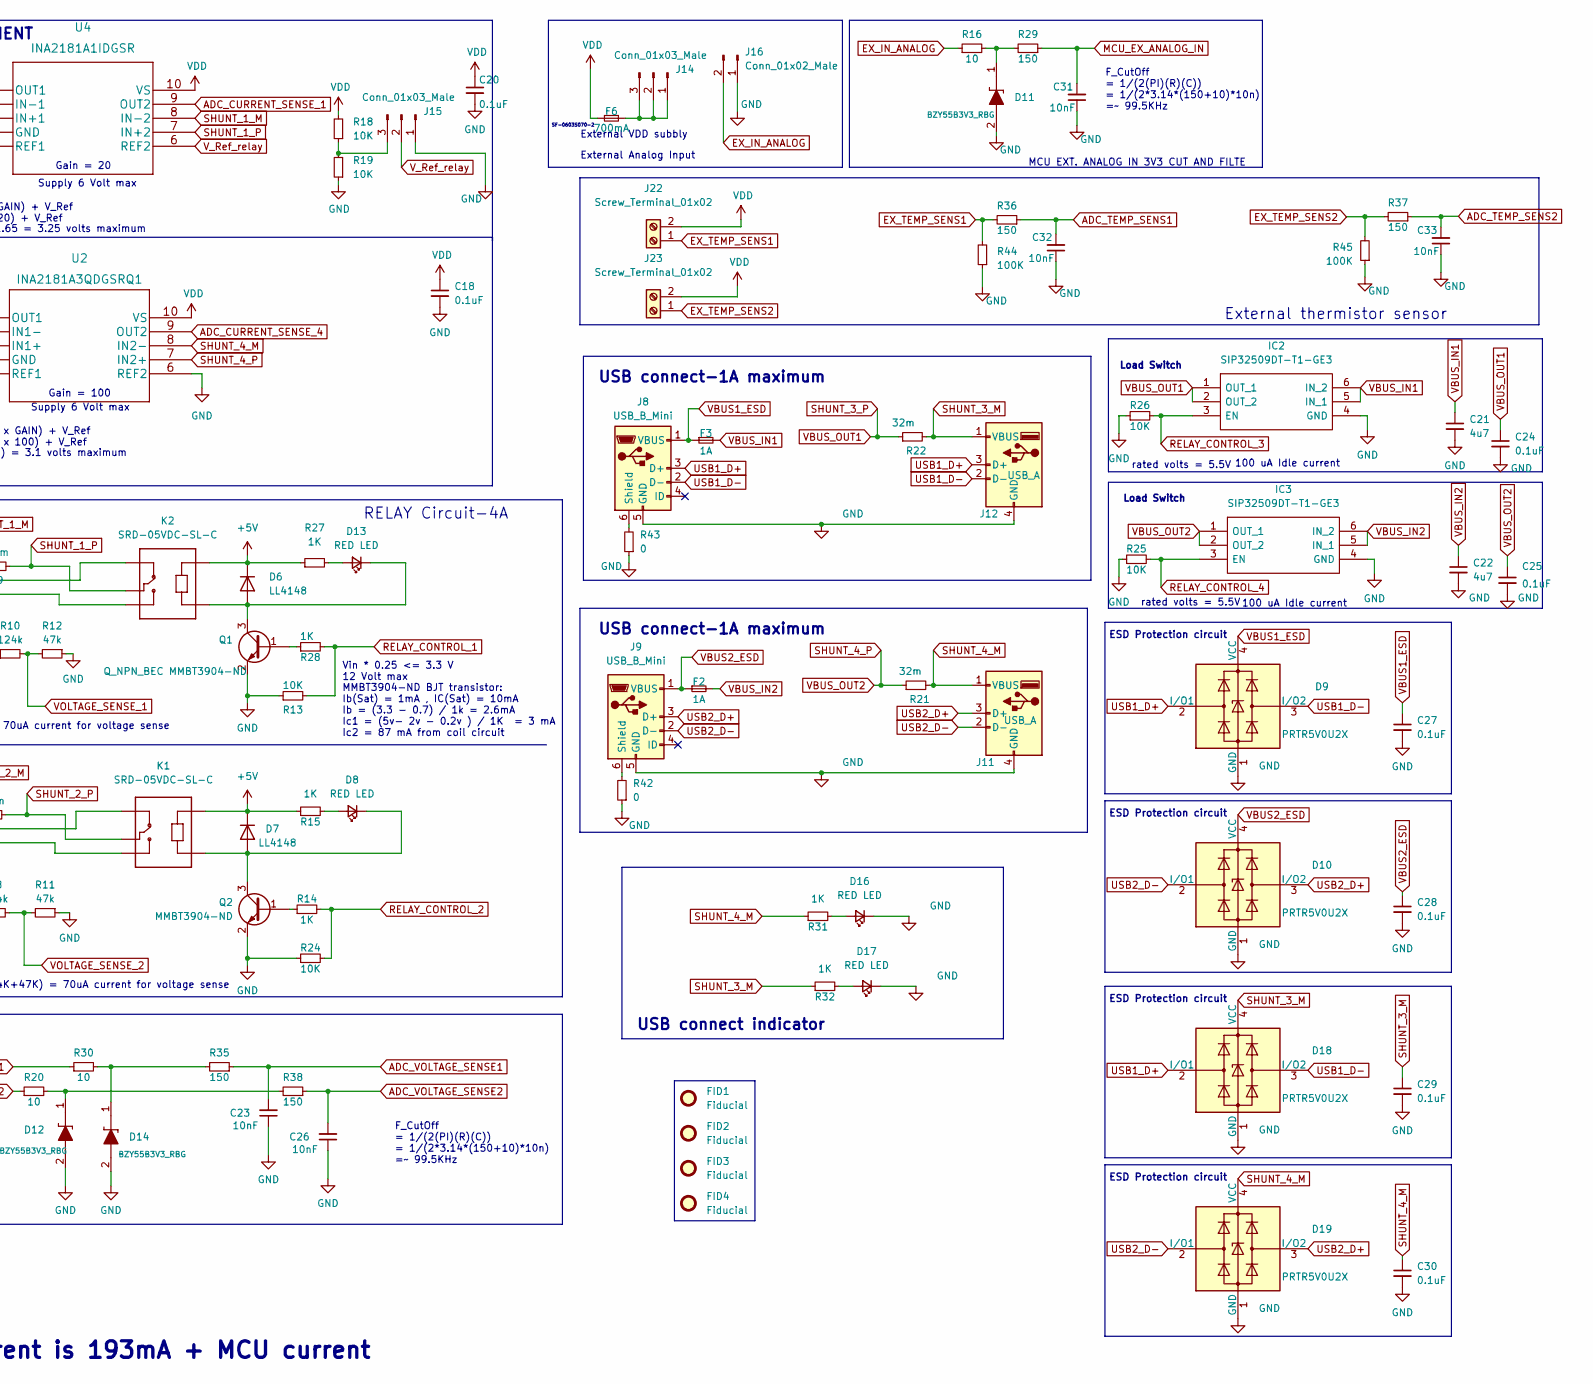
[picture p29: schematic usb_relay_control.kicad_sch, USB relay circuit, part in row 1, column 2]

Parts:
C1, C2: 8pF; C_0805_2012Metric
C3, C10, C14, C21, C22: 4u7; C_0805_2012Metric
C4, C5, C7, C8, C9: 10uF; C_0805_2012Metric
C6, C11: 1uF; C_0805_2012Metric
C12, C13, C23, C26, C31, C32, C33: 10nF; C_0805_2012Metric
C15, C16, C17, C18, C20, C24, C25, C27, C28, C29, C30, C70: 0.1uF; C_0805_2012Metric
C19: 4.7nF; C_0805_2012Metric
C69: 47u; C_0805_2012Metric
D1, D2, D8, D13, D16, D17: RED LED; LED_0805_2012Metric
D3: GREEN LED; LED_0805_2012Metric
D4: BLUE LED; LED_0805_2012Metric
D5, D9, D10, D18, D19: PRTR5V0U2X; SOT-143
D6, D7: LL4148; D_MiniMELF
D11, D12, D14: BZY55B3V3_RBG; BZY55B3V3RBG; Mouser Part Number 821-BZY55B3V3RBG
F1, F2, F3: 1A; Fuse_0805_2012Metric
F4, F5: 28mA; Fuse_0603_1608Metric
F6: 700mA; Fuse_0603_1608Metric
FB1, FB2, FB3: 100 Ohm @ 100MHz; L_0805_2012Metric
FID1, FID2, FID3, FID4: Fiducial; Fiducial_0.5mm_Mask1mm
H1, H2, H3, H4: MountingHole_Pad; MountingHole_2.5mm_Pad_Via
IC1: LDL1117S33R; SOT230P700X180-4N; Mouser Part Number 511-LDL1117S33R
IC2, IC3: SIP32509DT-T1-GE3; SOT95P284X110-6N; Manufacturer_Part_Number SIP32509DT-T1-GE3; Mouser Part Number 78-SIP32509DT-T1-GE3
J1: 8.06.04_J-LINK_NEEDLE_ADAPTER; SEGGER_8.06.04_J-LINK_NEEDLE_ADAPTER; PARTREV A
J2, J8, J9: USB_B_Mini; USB_Mini-B_Lumberg_2486_01_Horizontal
J3, J13, J14, J15, J17, J18: Conn_01x03_Male; PinHeader_1x03_P2.54mm_Vertical
J4, J16, J20, J21: Conn_01x02_Male; PinHeader_1x02_P2.54mm_Vertical
J5, J19: Conn_01x05_Male; PinHeader_1x05_P2.54mm_Vertical
J6, J7: Screw_Terminal_01x04; TerminalBlock_Phoenix_MKDS-1,5-4_1x04_P5.00mm_Horizontal
J10: 2301843-1; 23018432; Manufacturer_Part_Number 2301843-2; Mouser Part Number 571-2301843-2
J11, J12: USB_A; J_SMD_292303-9-4_2,2.5_14.85_14.06_8.9
J22, J23: Screw_Terminal_01x02; CONN_OSTVN02A150_OST
K1, K2: SRD-05VDC-SL-C; RELAY_SRD-05VDC-SL-C
Q1: Q_NPN_BEC MMBT3904-ND; SOT-23
Q2: MMBT3904-ND; SOT-23
R1, R3: 332; R_0805_2012Metric
R2, R6, R13, R18, R19, R24, R25, R26, R39, R40: 10K; R_0805_2012Metric
R4: 300; R_0805_2012Metric
R5: 167; R_0805_2012Metric
R7, R9: 20m; R_2010_5025Metric
R8, R10: 124k; R_0805_2012Metric
R11, R12: 47k; R_0805_2012Metric
R14, R15, R27, R28, R31, R32: 1K; R_0805_2012Metric
R16, R20, R30: 10; R_0805_2012Metric
R17, R23: 1.78k; R_0805_2012Metric
R21, R22: 32m; R_2512_6332Metric
R29, R35, R36, R37, R38: 150; R_0805_2012Metric
R33, R34: 60.4 Ohm; R_0805_2012Metric
R41, R42, R43: 0; R_0805_2012Metric
R44, R45: 100K; R_0805_2012Metric
R46: 1k5; R_0805_2012Metric
SW1, SW2: SW_Push; SW_SPST_B3U-1000P
U1: STM32F103CBTx; LQFP-48_7x7mm_P0.5mm
U2: INA2181A3QDGSRQ1
U3: TJA1051T-3; SOIC-8_3.9x4.9mm_P1.27mm
U4: INA2181A1IDGSR
Y1: 16 MHz Crystal; Crystal_SMD_SeikoEpson_FA238-4Pin_3.2x2.5mm

Connections:
+5V: C6.1, D6.1 (K), D7.1 (K), F1.2, IC1.3 (VIN), K1.A2, K2.A2, R15.1, R27.1, U3.3 (VCC); also elsewhere on the board
ADC_CURRENT_SENSE_1: U1.10 (PA0), U4.9 (OUT2)
ADC_CURRENT_SENSE_2: U1.11 (PA1), U4.1 (OUT1)
ADC_CURRENT_SENSE_3: U1.12 (PA2), U2.1 (OUT1)
ADC_CURRENT_SENSE_4: U1.13 (PA3), U2.9 (OUT2)
ADC_TEMP_SENS1: C32.2, R36.1, U1.16 (PA6)
ADC_TEMP_SENS2: C33.2, R37.1, U1.17 (PA7)
ADC_VOLTAGE_SENSE1: C23.2, R35.1, U1.14 (PA4)
ADC_VOLTAGE_SENSE2: C26.2, R38.1, U1.15 (PA5)
BLUE_LED: R5.1, U1.4 (PC15)
BOOT0: R2.1, SW1.1, U1.44 (BOOT0)
CANH: J10.7, R33.1, U3.7 (CANH)
CANL: J10.2, R34.2, U3.6 (CANL)
CAN_RX: U1.45 (PB8), U3.4 (RXD)
CAN_SILENCE: U1.41 (PB5), U3.8 (S)
CAN_TX: U1.46 (PB9), U3.1 (TXD)
EX_IN_ANALOG: J16.2, R16.1
EX_TEMP_SENS1: J22.1, R36.2, R44.2
EX_TEMP_SENS2: J23.1, R37.2, R45.2
GND: C1.2, C2.2, C3.2, C4.2, C5.2, C6.2, C7.2, C8.2, C9.2, C10.2, C11.2, C12.2, C13.2, C14.2, C15.2, C16.2, C17.2, C18.2, C19.2, C20.2, C21.2, C22.2, C23.1, C24.2, C25.2, C26.1, C27.2, C28.2, C29.2, C30.2, C31.1, C32.1, C33.1, D1.1 (K), D2.1 (K), D3.1 (K), D4.1 (K), D5.1 (GND), D9.1 (GND), D10.1 (GND), D11.2, D12.2, D14.2, D16.1 (K), D17.1 (K), D18.1 (GND), D19.1 (GND), FB2.2, H1.1, H2.1, H3.1, H4.1, IC1.1 (GND), IC2.4 (GND), IC3.4 (GND), J1.3 (GND), J1.9 (TRST), J3.1, J5.1, J6.4, J7.4, J8.5 (GND), J9.5 (GND), J10.3, J11.4 (GND), J12.4 (GND), J13.1, J15.1, J16.1, J17.1, J18.1, J19.1, Q1.2 (E), Q2.2 (E), R2.2, R11.1, R12.1, R13.1, R19.1, R24.1, R25.1, R26.1, R39.2, R40.2, R41.1, R42.1, R43.1, R44.1, R45.1, SW2.1, U1.8 (VSSA), U1.23 (VSS), U1.35 (VSS), U1.47 (VSS), U2.4 (GND), U2.5 (REF1), U2.6 (REF2), U3.2 (GND), U4.4 (GND), Y1.2, Y1.4; also elsewhere on the board
GREEN_LED: R4.1, U1.3 (PC14)
HSE_IN: C1.1, U1.5 (PD0), Y1.1
HSE_OUT: C2.1, U1.6 (PD1), Y1.3
I2C_SCK: J3.3, J17.3, J21.1, U1.21 (PB10)
I2C_SDA: J3.2, J17.2, J20.1, U1.22 (PB11)
JTD0_TRACESWO: J1.6 (SWO/TDO), U1.39 (PB3)
JTDI: J1.8 (TDI), U1.38 (PA15)
MCU_EX_ANALOG_IN: C31.2, R29.1, U1.18 (PB0)
NRST: C17.1, J1.10 (NRST), R6.2, SW2.2, U1.7 (NRST)
unnamed: C16.1, F1.1, FB3.2
unnamed: C19.1, R33.2, R34.1
unnamed: D1.2 (A), R1.2
unnamed: D2.2 (A), R3.2
unnamed: D3.2 (A), R4.2
unnamed: D4.2 (A), R5.2
unnamed: D7.2 (A), D8.1 (K), K1.A1, Q2.3 (C)
unnamed: D8.2 (A), R15.2
unnamed: D11.1, R16.2, R29.2
unnamed: D12.1, R20.2, R38.2
unnamed: D13.2 (A), R27.2
unnamed: D6.2 (A), D13.1 (K), K2.A1, Q1.3 (C)
unnamed: D14.1, R30.2, R35.2
unnamed: D16.2 (A), R31.2
unnamed: D17.2 (A), R32.2
unnamed: FB2.1, J2.5 (GND)
unnamed: J2.6 (Shield), R41.2
unnamed: F4.1, J4.1
unnamed: F5.1, J4.2
unnamed: J6.2, K1.NC
unnamed: J6.3, K1.NO, R8.1
unnamed: J7.2, K2.NC
unnamed: J7.3, K2.NO, R10.1
unnamed: J8.6 (Shield), R43.2
unnamed: J9.6 (Shield), R42.2
unnamed: F6.2, J14.1, J14.2, J14.3
unnamed: J15.3, R18.1, R19.2
unnamed: J20.2, R17.2
unnamed: J21.2, R23.2
unnamed: Q1.1 (B), R28.1
unnamed: Q2.1 (B), R14.1
PA10: F4.2, R39.1, U1.31 (PA10)
PB4: F5.2, R40.1, U1.40 (PB4)
RED_LED: R3.1, U1.2 (PC13)
RELAY_CONTROL_1: R13.2, R28.2, U1.29 (PA8)
RELAY_CONTROL_2: R14.2, R24.2, U1.30 (PA9)
RELAY_CONTROL_3: IC2.3 (EN), R26.2, U1.19 (PB1)
RELAY_CONTROL_4: IC3.3 (EN), R25.2, U1.20 (PB2)
SHUNT_1_M: J7.1, R9.1, U4.8 (IN-2)
SHUNT_1_P: K2.COM, R9.2, U4.7 (IN+2)
SHUNT_2_M: J6.1, R7.1, U4.2 (IN-1)
SHUNT_2_P: K1.COM, R7.2, U4.3 (IN+1)
SHUNT_3_M: C29.1, D18.4 (VCC), J12.1 (VBUS), R22.2, R32.1, U2.2 (IN1-)
SHUNT_3_P: C24.1, IC2.1 (OUT_1), IC2.2 (OUT_2), R22.1, U2.3 (IN1+)
SHUNT_4_M: C30.1, D19.4 (VCC), J11.1 (VBUS), R21.2, R31.1, U2.8 (IN2-)
SHUNT_4_P: C25.1, IC3.1 (OUT_1), IC3.2 (OUT_2), R21.1, U2.7 (IN2+)
SPI_CS: J5.2, J19.2, U1.25 (PB12)
SPI_MISO: J5.4, J19.4, U1.27 (PB14)
SPI_MOSI: J5.5, J19.5, U1.28 (PB15)
SPI_SCK: J5.3, J19.3, U1.26 (PB13)
SWCLK: J1.4 (SWCLK/TCK), U1.37 (PA14)
SWDIO: J1.2 (SWDIO/TMS), U1.34 (PA13)
UART_RX: J13.3, J18.3, U1.43 (PB7)
UART_TX: J13.2, J18.2, U1.42 (PB6)
USB1_D+: D9.2 (I/O1), D18.2 (I/O1), J8.3 (D+), J12.3 (D+)
USB1_D-: D9.3 (I/O2), D18.3 (I/O2), J8.2 (D-), J12.2 (D-)
USB2_D+: D10.3 (I/O2), D19.3 (I/O2), J9.3 (D+), J11.3 (D+)
USB2_D-: D10.2 (I/O1), D19.2 (I/O1), J9.2 (D-), J11.2 (D-)
USB_D+: D5.2 (I/O1), J2.3 (D+), R46.2, U1.33 (PA12)
USB_D-: D5.3 (I/O2), J2.2 (D-), U1.32 (PA11)
VBUS1_ESD: C27.1, D9.4 (VCC), F3.1, J8.1 (VBUS)
VBUS2_ESD: C28.1, D10.4 (VCC), F2.1, J9.1 (VBUS)
VBUS_IN1: C21.1, F3.2, IC2.5 (IN_1), IC2.6 (IN_2)
VBUS_IN2: C22.1, F2.2, IC3.5 (IN_1), IC3.6 (IN_2)
VBus_5V: C12.1, C14.1, C15.1, D5.4 (VCC), FB3.1, J2.1 (VBUS)
VDD: C3.1, C4.1, C5.1, C7.1, C8.1, C9.1, C10.1, C18.1, C20.1, F6.1, FB1.1, IC1.2 (VOUT_1), IC1.4 (VOUT_2), J1.1 (VTREF), J22.2, J23.2, R1.1, R6.1, R17.1, R18.2, R23.1, R46.1, SW1.2, U1.1 (VBAT), U1.24 (VDD), U1.36 (VDD), U1.48 (VDD), U2.10 (VS), U3.5 (VIO), U4.10 (VS)
VDDA: C11.1, C13.1, FB1.2, U1.9 (VDDA)
VOLTAGE_SENSE_1: R10.2, R12.2, R30.1
VOLTAGE_SENSE_2: R8.2, R11.2, R20.1
V_Ref_relay: J15.2, U4.5 (REF1), U4.6 (REF2)

Notes on the sheet:
USB connect indicator
Supply 6 Volt max
100 uA Idle current
V_Out = (I_Load x R_Sense x GAIN) + V_Ref V_Out = (I_Load x R_Sense x 20) + V_Ref
Mounting Holes
F_CutOff = 1/(2(PI)(R)(C)) = 1/(2*3.14*(150+10)*10n) =~ 99.5KHz
ESD Protection circuit
External VDD subbly
J-Link Connector
Boot pin
Microcontroller
Load Switch
V_Out = (I_Load x R_Sense x GAIN) + V_Ref V_Out = (I_Load x R_Sense x 100) + V_Ref
check stm32f103cb DS page 36
RED led voltage drop = 2.2v GREEN led voltage drop = 2.4v BLUE led voltage drop = 2.8v
V_Out = (4 x 0.020 x 20) + 1.65 = 3.25 volts maximum
I = 3 mA
USB connect-1A maximum
POWER LED
the crystal load capacitance is 8pF, and assuming Cstray=4pF, then: CX1 = CX2 = 2(9pF - 5pF) = 8pF
MMBT3904-ND BJT transistor: Ib(Sat) = 1mA , IC(Sat) = 10mA Ib = (3.3 - 0.7) / 1k = 2.6mA Ic1 = (5v- 2v - 0.2v ) / 1K = 3 mA Ic2 = 87 mA from coil circuit
stm32f103 DS page 67
D+ must pulled up to 1k5 resistor
RELAY Circuit-4A
EXTERNAL PIN HEADERS
Vin * 0.25 <= 3.3 V 12 Volt max
External thermistor sensor
Vin * (47/124+47) <= 3.3 V 12 Volt max
ECS-160-9-33B-CTP-TR
MCU EXT. ANALOG IN 3V3 CUT AND FILTE
Voltage regulation
ADC Protection
Gain = 20
Decoupling capacitor
70uA current for voltage sense
CURRENT MEASUREMENT
26 Volts max
Reset circuit
rated volts = 5.5V
SF-0603S070-2
External Analog Input
F0603G0R02FNTR
CAN transciever
USB connect
V_Out = (1A x 0.032 x 100) = 3.1 volts maximum
Crystal circuit
MAX Current is 193mA + MCU current
Debug led
Gain = 100
Analog voltage Filtering
5.5 volts MAX
12/(124K+47K) = 70uA current for voltage sense

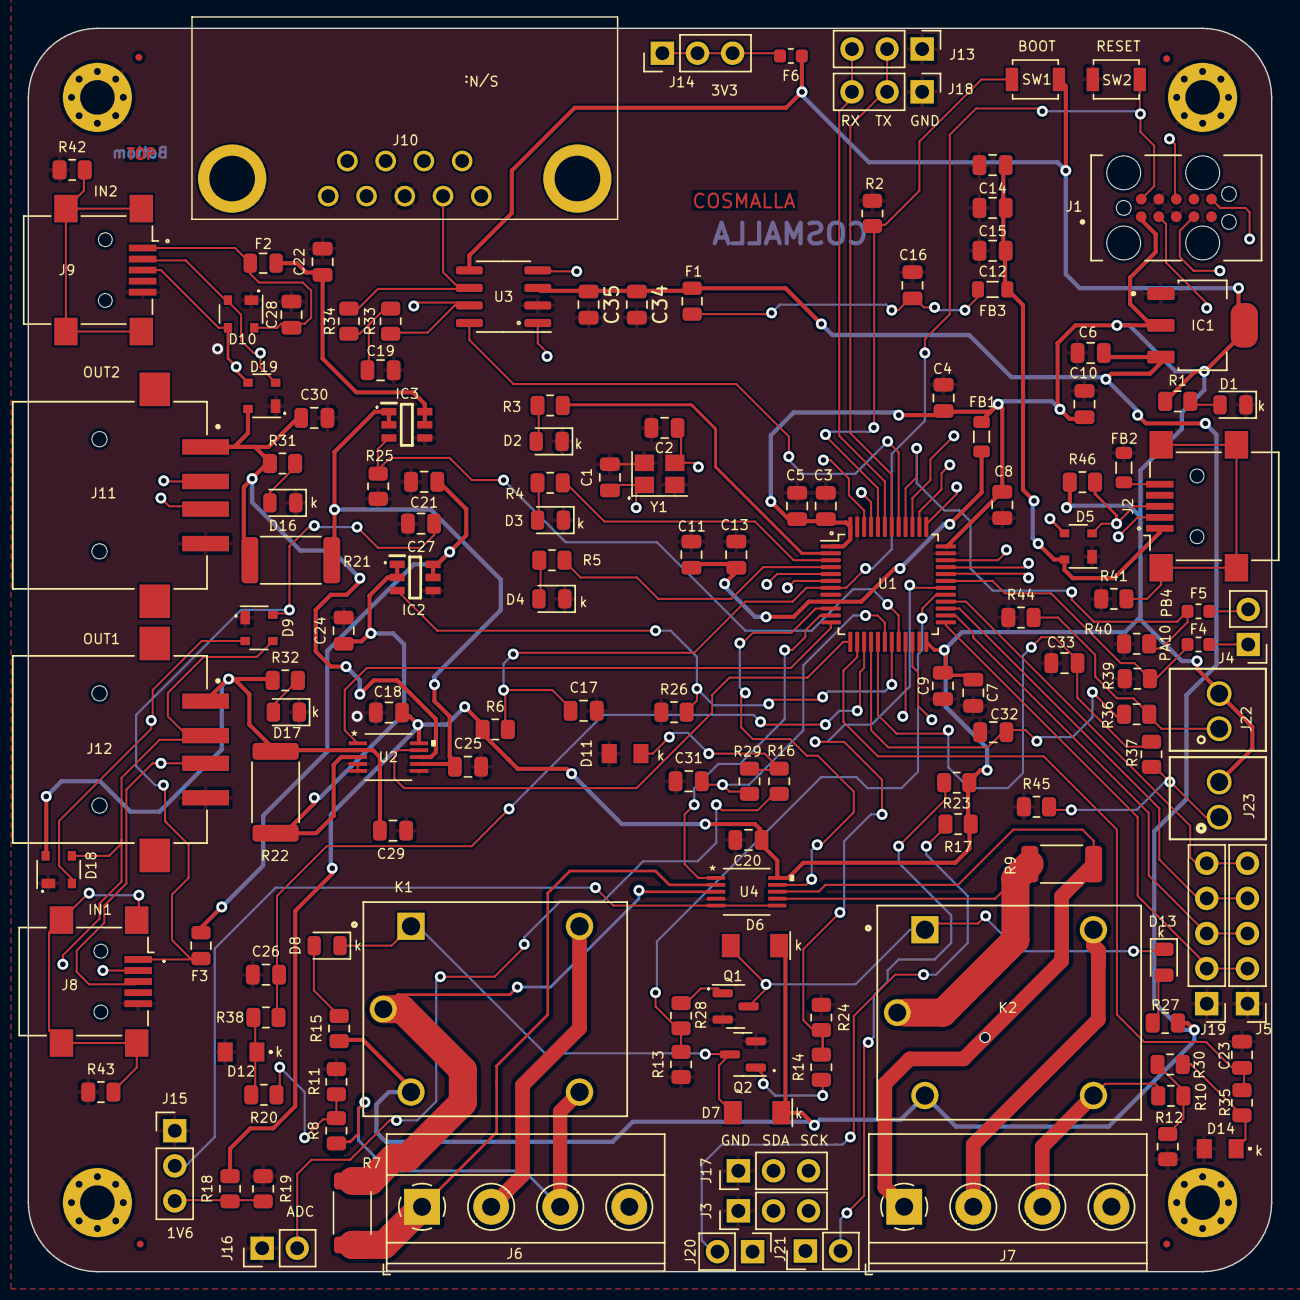
[picture p30: board usb_relay_control.kicad_pcb from above]

Board: 4 copper layers, 90.0 x 90.0 mm, 153 parts (0 on the bottom side), 99 nets.

Other parts of the board:
C34: 47u; C_0805_2012Metric
C35: 0.1uF; C_0805_2012Metric

Their connections:
+5V: C34.1, C35.1; also elsewhere on the board
GND: C34.2, C35.2; also elsewhere on the board
