MohamedMehery/Cosmalla_controller/Code/Core/Src/main.c

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
/* Includes ------------------------------------------------------------------*/
#include "main.h"

ADC_HandleTypeDef hadc1;
DMA_HandleTypeDef hdma_adc1;

CAN_HandleTypeDef hcan;

I2C_HandleTypeDef hi2c2;

SPI_HandleTypeDef hspi2;

TIM_HandleTypeDef htim1;

PCD_HandleTypeDef hpcd_USB_FS;

/* USER CODE BEGIN PV */
volatile uint8_t duty_cycle = 1; // 1 to 10 (representing 10% to 100%)
volatile uint8_t pwm_counter = 0;
volatile int8_t step_dir = 1;    // 1 for increasing, -1 for decreasing
/* USER CODE END PV */

void SystemClock_Config(void);
static void MX_GPIO_Init(void);
static void MX_DMA_Init(void);
static void MX_ADC1_Init(void);
static void MX_TIM1_Init(void);
static void MX_USB_PCD_Init(void);
static void MX_I2C2_Init(void);
static void MX_CAN_Init(void);
static void MX_SPI2_Init(void);
/**
  * @brief  The application entry point.
  * @retval int
  */
int main(void)
{
  /* MCU Configuration--------------------------------------------------------*/

  /* Reset of all peripherals, Initializes the Flash interface and the Systick. */
  HAL_Init();

  /* Configure the system clock */
  SystemClock_Config();

  /* Initialize all configured peripherals */
  MX_GPIO_Init();
//  MX_DMA_Init();
//  MX_ADC1_Init();
  MX_TIM1_Init();
//  MX_USB_PCD_Init();
//  MX_I2C2_Init();
//  MX_CAN_Init();
//  MX_SPI2_Init();
  /* USER CODE BEGIN 2 */
  // Start TIM1 timer to generate interrupts every 100ms
  HAL_TIM_Base_Start_IT(&htim1);
  /* USER CODE END 2 */

  /* Infinite loop */
  /* USER CODE BEGIN WHILE */
  while (1)
  {
    /* USER CODE END WHILE */

    /* USER CODE BEGIN 3 */
  }
  /* USER CODE END 3 */
}

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
/* USER CODE BEGIN 4 */
/**
  * @brief  Period elapsed callback in non blocking mode
  * @param  htim : TIM handle
  * @retval None
  */
void HAL_TIM_PeriodElapsedCallback(TIM_HandleTypeDef *htim)
{
  if (htim->Instance == TIM1)
  {
    static uint16_t update_counter = 0;
    
    // PWM logic: increment pwm_counter every 1ms
    pwm_counter++;
    if (pwm_counter >= 10)
    {
      pwm_counter = 0;
    }
    
    // Bluepill LED is active low (RESET = ON, SET = OFF)
    if (pwm_counter < duty_cycle)
    {
      HAL_GPIO_WritePin(RED_GPIO_Port, RED_Pin, GPIO_PIN_RESET);
    }
    else
    {
      HAL_GPIO_WritePin(RED_GPIO_Port, RED_Pin, GPIO_PIN_SET);
    }
    
    // Update duty cycle every 100ms (every 100 interrupts)
    update_counter++;
    if (update_counter >= 100)
    {
      update_counter = 0;
      duty_cycle += step_dir;
      
      // Reverse direction if limits are reached
      if (duty_cycle >= 10)
      {
        duty_cycle = 10;
        step_dir = -1; // Start dimming
      }
      else if (duty_cycle <= 1)
      {
        duty_cycle = 1;
        step_dir = 1;  // Start rising
      }
    }
  }
}
/* USER CODE END 4 */
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
