MohamedMehery/Cosmalla_controller/Code/Core/Inc/main.h

#define RED_Pin GPIO_PIN_13
#define RED_GPIO_Port GPIOC
#define GREEN_Pin GPIO_PIN_14
#define GREEN_GPIO_Port GPIOC
#define BLUE_Pin GPIO_PIN_15
#define BLUE_GPIO_Port GPIOC
#define RESERVED_0_Pin GPIO_PIN_0
#define RESERVED_0_GPIO_Port GPIOB
#define RESERVED_1_Pin GPIO_PIN_1
#define RESERVED_1_GPIO_Port GPIOB
#define RESERVED_2_Pin GPIO_PIN_2
#define RESERVED_2_GPIO_Port GPIOB
#define RELAY_CONTROL_4_Pin GPIO_PIN_8
#define RELAY_CONTROL_4_GPIO_Port GPIOA
#define CAN_SILENCE_Pin GPIO_PIN_9
#define CAN_SILENCE_GPIO_Port GPIOA
#define RESERVED_3_Pin GPIO_PIN_4
#define RESERVED_3_GPIO_Port GPIOB
#define RELAY_CONTROL_1_Pin GPIO_PIN_5
#define RELAY_CONTROL_1_GPIO_Port GPIOB
#define RELAY_CONTROL_2_Pin GPIO_PIN_6
#define RELAY_CONTROL_2_GPIO_Port GPIOB
#define RELAY_CONTROL_3_Pin GPIO_PIN_7
#define RELAY_CONTROL_3_GPIO_Port GPIOB
