MohamedMehery/Cosmalla_controller/(commit log)

2026-05-08 ADD: AI antigravity review EMC according to IPC2221
    [2301843-1.stp, 292303-9.step, 292303-9.stp, 87583-3010RPALF--3DModel-STEP-269445.STEP, 87583-3010RPALF.stp, BUK6Y24-40PX.stp, BZX84C3V3.stp, BZY55B3V3_RBG.stp]
2026-05-08 Fix HardFault by correcting clock config and implement LED dimming software PWM
    [main.c, main.h]
